CaioHVectorA/rover/README.md

# 🤖 Rover Móvel ESP32-S3 4WD & Pan/Tilt VR

Robô explorador terrestre com **tração integral 4WD**, cabeça articulada **Pan/Tilt** com streaming de vídeo de baixa latência e controle mobile imersivo via **Realidade Virtual (VR Head-Tracking)**.

---

### 🟢 Status do Projeto: **Robô montado & Testes práticos em andamento**
* **Hardware (V1 Montado):** Robô montado fisicamente (chassi 3D protótipo, rodas de 32 mm com 8 mm de vão livre, placa perfurada concluída).
* **Próxima Geração (PCB V2):** Transição direta para a PCB definitiva ([`rover_pcb_v2_chassi`](docs/hardware/kicad/rover_pcb_v2_chassi/MONTAGEM_3D.md)) com **ESP32 interno no chassi**, comunicação via **UART Serial Direta 3.3V** e áudio I2S (`INMP441` + `MAX98357A`).
* **Firmware & Visão:** ESP32-S3 e Nano operacionais com visão computacional (modo apresentador / gestos) em testes práticos.
* **Próximo passo:** Fabricar/montar a PCB V2, ajustar o chassi 3D para a nova placa e implementar o pipeline de vídeo UDP + servidor de IA.

---

## 🏗️ Arquitetura do Sistema

O projeto adota uma arquitetura **distribuída em 2 microcontroladores**, interligados por um chicote ultra-flexível de **apenas 3 a 4 fios**:

```mermaid
flowchart TD
    subgraph APP["📱 App Mobile (Expo / React Native) / Navegador Web"]
        VR["Modo VR Head-Tracking / FPV"]
        WS_CLI["WebSocket Client (JSON ou ASCII @ 35Hz)"]
        STREAM_CLI["Player de Vídeo MJPEG (:82/stream)"]
    end

    subgraph CABECA["📸 Cabeça Móvel (Pan / Tilt)"]
        ESP["ESP32-S3-CAM (Wi-Fi + Câmera 5MP OV5640)"]
        HTTPD["esp_http_server Dedicado no Core 0 (:82)"]
        CAM_PWR["Soneca Térmica no Reg. 0x3008"]
    end

    subgraph CHASSI["⚡ Chassi Fixo Inferior"]
        STEP["Mini 560 (5V / até 5A)"]
        BAT["Bateria Li-Ion 2S (7.4V 2500mAh)"]
        NANO["Arduino Nano V3 (5V Nativo)"]
        DRIVER["Driver TB6612FNG (MOSFET Duplo)"]
        MOTORES["4x Motores DC JGA16-050"]
        SERVOS["2x Micro Servos SG90 (Pan/Tilt)"]
        RAMPA["Rampa Soft-Start & Dead-Time"]
    end

    APP <== "Wi-Fi (Portas 80, 81 e 82)" ==> ESP
    BAT --> STEP
    BAT --> DRIVER

    %% Chicote Flexível
    STEP -.->|"Fio 1: 5.0V (Potência)"| ESP
    NANO -.->|"Fio 2: GND Comum"| ESP
    ESP -.->|"Fio 3: IO43 TX -> Nano D2 RX (via BC337 ou D0 direto)"| NANO
    NANO -.->|"Fio 4 (Opcional): Nano D1 TX -> Divisor 1k/2k -> IO44 RX"| ESP

    NANO --> DRIVER --> MOTORES
    NANO --> SERVOS
```

---

## 🔬 Suíte dos 6 POCs (Testes de Bancada Independentes)

Cada subsistema foi desacoplado para testes isolados e seguros:

| POC | Descrição | Placa & Ambiente | O que testa / resolve |
|---|---|---|---|
| **POC 1** | [Enlace Serial RX/TX](file:///c:/Users/caihe/Documents/develop/rover/docs/pocs/GUIA_EXECUCAO_POCS.md#poc-1-teste-de-enlace-serial-rxtx-com-servidor-web) | `poc1_esp32` + `poc1_nano` | Medição de ping/RTT, taxa de entrega de 100% e diagnóstico de reset do Nano |
| **POC 2** | [Pan/Tilt Controlado (Sem Vídeo)](file:///c:/Users/caihe/Documents/develop/rover/docs/pocs/GUIA_EXECUCAO_POCS.md#poc-2-pantilt-controlado-sem-v%C3%ADdeo) | `poc2_esp32` + `poc2_nano` | Eliminação do "rebolado" via interpolação em microssegundos (50 Hz) e varredura lenta |
| **POC 3** | [Transmissão de Vídeo Fria](file:///c:/Users/caihe/Documents/develop/rover/docs/pocs/GUIA_EXECUCAO_POCS.md#poc-3-transmiss%C3%A3o-de-v%C3%ADdeo-fria-esp32-isolado) | `poc3_esp32` | Soneca no reg. `0x3008`, XCLK adaptativo (8–12 MHz) e servidor no Core 0 (câmera fria) |
| **POC 4** | [Pan/Tilt + Transmissão](file:///c:/Users/caihe/Documents/develop/rover/docs/pocs/GUIA_EXECUCAO_POCS.md#poc-4-pantilt--transmiss%C3%A3o-desempenho-da-imagem) | `poc4_esp32` + `poc2_nano` | Operação simultânea com modo Eco automático (cai para 5 FPS parado) e zero bloqueio |
| **POC 5** | [Teste Automático dos Motores](file:///c:/Users/caihe/Documents/develop/rover/docs/pocs/GUIA_EXECUCAO_POCS.md#poc-5-teste-autom%C3%A1tico-de-motores-4wd-bancada-com-rodas-no-ar) | `poc5_nano` (baud 115200) | Sequência autônoma de vai-e-volta, giros e rampa com medição de queda (*sag*) de bateria |
| **POC 6** | [Motores Controlados](file:///c:/Users/caihe/Documents/develop/rover/docs/pocs/GUIA_EXECUCAO_POCS.md#poc-6-motores-controlados-joystick-virtual--teclado) | `poc6_esp32` + `poc6_nano` | Pilotagem manual (joystick touch / teclado WASD), watchdog de 600ms e rampa anti-reset |

📖 **Consulte o [Guia Completo de Execução dos POCs](file:///c:/Users/caihe/Documents/develop/rover/docs/pocs/GUIA_EXECUCAO_POCS.md)** para instruções de compilação, gravação e checklist.

---

## 📂 Organização Limpa da Codebase

```
rover/
├── README.md                      # Visão geral, arquitetura e quickstart
├── AGENTS.md                      # Diretrizes obrigatórias e regras para agentes de IA
├── style.md                       # Perfil de engenharia, tom de bancada e preferências
├── platformio.ini                 # Configuração unificada de build de todos os ambientes
│
├── docs/                          # Documentação técnica central
│   ├── context.md                 # 📖 Memória técnica contínua e histórico completo do projeto
│   ├── pocs/                      # Documentação da suíte de 6 POCs incrementais
│   │   ├── README.md              # Índice dos POCs e tabela de ambientes
│   │   └── GUIA_EXECUCAO_POCS.md  # Manual prático de gravação e teste passo a passo
│   ├── hardware/                  # Especificações técnicas, desenhos com cotas e pinagens
│   │   ├── ESPECIFICACOES_TECNICAS.md
│   │   ├── tabela_pinagem_esp32_nano.xlsx
│   │   ├── PROJETO_CONEXOES_PLACA_PERFURADA.docx
│   │   ├── kicad/                 # Projetos de circuitos e esquemáticos KiCad
│   │   └── *.png                  # Desenhos técnicos oficiais (JGA-050, SG90, StickyMAX)
│   ├── guides/                    # Guias de engenharia aprofundados
│   │   ├── camera_calor_software.md          # ❄️ Otimização térmica do OV5640 via software
│   │   ├── ajuste_fino_servos_rebolado.md    # 🎯 Física e eliminação do rebolado nos servos SG90
│   │   ├── tracao_motores_anti_reset.md      # ⚡ Prevenção de Brown-Out e rampa 4WD na TB6612
│   │   ├── controle_servos_head_tracking_vr.md # Guia didático de servos e VR Head-Tracking
│   │   ├── http_vs_websocket_redes.md        # Análise comparativa de protocolos de rede
│   │   └── streaming_video_baixa_latencia.md # Pipeline de vídeo MJPEG e baixa latência
│   ├── compras/                   # Histórico de compras, orçamentos e fotos das lojas
│   └── references/                # Fotos reais dos produtos e montagens maker de referência
│
├── src/                           # Código-fonte do projeto
│   ├── firmware/                  # Códigos C++ / Arduino organizados por módulo
│   │   ├── comum/                 # Módulos compartilhados reutilizáveis (câmera, enlace, rampa, servos)
│   │   ├── pocs/                  # Códigos-fonte dos 6 POCs isolados
│   │   ├── gateway_app/           # Firmware de produção integrado ao App Mobile Expo
│   │   └── legado/                # Sketches e testes históricos arquivados
│   ├── app_mobile/                # Aplicativo Expo / React Native (VR, FPV e Dashboard)
│   └── servidor_relay/            # Servidor Node.js / Docker para teleoperação em nuvem
│
└── tools/                         # Ferramentas auxiliares e geradores Python
    └── scratch/                   # Scripts utilitários de apoio
```

---

## ⚡ Comandos de Compilação e Gravação (PlatformIO)

Substitua `COMx` pelas portas seriais reais conectadas:

```powershell
# Gravação do ESP32-S3 (Exemplo POC 4: Pan/Tilt + Câmera):
pio run -e poc4_esp32 -t upload --upload-port COM24

# Gravação do Arduino Nano (Exemplo POC 2/4: Servos Suaves):
pio run -e poc2_nano -t upload --upload-port COM18

# Teste autônomo dos motores (POC 5):
pio run -e poc5_nano -t upload --upload-port COM18
pio device monitor -e poc5_nano --port COM18
```

---

## ⚙️ Componentes Físicos Adquiridos & Validados

| Componente | Modelo / Especificação | Função no Rover |
| :--- | :--- | :--- |
| **Motores de Tração** | 4x **JGA16-050** (16mm, redução metálica, eixo D 3mm) | Tração 4WD com torque elevado |
| **Rodas** | 4x **Rodas 32 mm** com cubo de fixação | Diâmetro externo de 32 mm elevando o vão livre para 8,0 mm |
| **Placa de Visão** | **ESP32-S3-CAM N16R8** (16MB Flash, 8MB PSRAM, OV5640 5MP) | Câmera, Wi-Fi e Streaming UDP Zero-Buffer |
| **Placa de Potência** | **Arduino Nano V3** (ATmega328P, 5V nativo) -> Migrando para **ESP32 DevKit V2** | Comanda TB6612, servos, buzzer e lê bateria |
| **Driver de Motores** | **TB6612FNG** (Ponte H MOSFET dupla, 1.2A/canal contínuo) | Controle de velocidade PWM e sentido 4WD |
| **Mecanismo Pan/Tilt** | 2x Micro Servos **SG90 9g** (Torque 1.6 kgf·cm) | Orientação horizontal e vertical da câmera |
| **Regulador de Tensão** | Step-Down **Mini 560** (5V fixos / até 5A) | Linha de 5V estável para placas e servos |
| **Bateria** | Li-Ion **2S 7.4V 2500mAh** com placa BMS integrada | Alimentação geral do robô |

> 📌 **Vão Livre ao Solo (Ground Clearance Real):**
> $$\text{Raio da Roda (16 mm)} - \text{Raio do Motor JGA (8 mm)} = \mathbf{8{,}0\text{ mm}}$$
> *A elevação para rodas de 32 mm resolveu o vão livre crítico de 3 mm das rodas de 22 mm anteriores, permitindo rodar em pisos reais sem raspar o motor.*
