CaioHVectorA/rover/ROADMAP.md

# 🗺️ Roadmap de Desenvolvimento - Robô Móvel ESP32-S3

Este documento estabelece o **plano de execução e marcos (milestones)** para o desenvolvimento do robô móvel. O foco primordial é a entrega rápida de um **MVP (Produto Mínimo Viável)** 100% funcional em rede Wi-Fi local antes de avançar para funcionalidades secundárias ou conexão de longa distância.

> 📚 **Documentos Relacionados:**
> * 🧠 [**`MEMORIA_DO_PROJETO.md`**](file:///home/usuario/Documentos/rover/MEMORIA_DO_PROJETO.md): Histórico completo de conversas, justificativas técnicas e soluções de engenharia.
> * 🛒 [**`linha-esp32-s3/LISTA_DE_COMPRAS.md`**](file:///home/usuario/Documentos/rover/linha-esp32-s3/LISTA_DE_COMPRAS.md): Lista consolidada de componentes no Mercado Livre e RoboCore.
> * 🏠 [**`README.md`**](file:///home/usuario/Documentos/rover/README.md): Visão geral do repositório.

---

## 🎯 1. Canvas do MVP (Visão Visual Rápida)

```
+---------------------------------------------------------------------------------------------------------+
|                                        CANVAS DO PROJETO - MVP                                          |
+------------------------------------+------------------------------------+-------------------------------+
| 1. OBJETIVO DO MVP                 | 2. HARDWARE DO MVP                 | 3. PILHA DE SOFTWARE          |
| • Robô 4WD comandado remotamente   | • ESP32-S3 CAM (N16R8 + OV5640)    | • Framework: Arduino/ESP-IDF  |
| • Streaming contínuo de vídeo      | • 4x Micromotores + 4 Rodas        | • Web Server: AsyncWebServer  |
| • Câmera com Pan & Tilt 2 eixos    | • Ponte H (L9110/MX1616 ou L298N)  | • Vídeo: Driver esp_camera    |
| • Operação em Wi-Fi Local (<100ms) | • 2x Micro Servos 9g SG90          | • Interface: HTML5/JS Web App |
|                                    | • Bateria 2S 18650 + Step-Down 5V  | • Comunicação: WebSockets     |
+------------------------------------+------------------------------------+-------------------------------+
| 4. INTERFACE DE CONTROLE (WEB APP) | 5. CRITÉRIO DE SUCESSO DO MVP      | 6. FASE SEGUINTE (PÓS-MVP)    |
| • Joystick/botões na tela          | • Pilotagem fluida pelo celular    | • Iluminação RGB (WS2812B)    |
| • Janela de vídeo ao vivo (MJPEG)  | • Câmera apontando em tempo real   | • Feedback sonoro (Buzzer)    |
| • Sliders para Pan e Tilt          | • Zero travamentos ou brownouts    | • Teleoperação 4G / Longa     |
| • Telemetria de sinal Wi-Fi        | • Sem quebra do flat da câmera     |   distância via internet      |
+------------------------------------+------------------------------------+-------------------------------+
```

---

## 📊 2. Diagrama de Fluxo de Fases

```mermaid
flowchart TD
    subgraph FASE_1 ["Fase 1: Bancada & Testes Unitários"]
        A1[Testar ESP32-S3 CAM com CameraWebServer] --> A2[Testar Servos Pan/Tilt em Bancada]
        A2 --> A3[Testar Ponte H e 4 Micromotores]
        A3 --> A4[Calibrar Step-Down para 5.0V]
    end

    subgraph FASE_2 ["Fase 2: Montagem Mecânica & Elétrica"]
        B1[Fixar Micromotores e Rodas no Chassi] --> B2[Instalar Suporte Pan/Tilt com o ESP32]
        B2 --> B3[Passar Chicote Flexível com Folga]
        B3 --> B4[Montar Bateria, Chave e Step-Down]
    end

    subgraph FASE_3 ["Fase 3: Firmware & Interface do MVP"]
        C1[Servidor Web com Streaming de Vídeo] --> C2[Endpoint WebSocket para Comandos Baixa Latência]
        C2 --> C3[Interface Web Mobile Responsiva]
        C3 --> C4[Validação Prática de Condução Wi-Fi]
    end

    subgraph FASE_4 ["Fase 4: Recursos Sensoriais"]
        D1[Instalação do Buzzer e Sons de Alerta] --> D2[Instalação dos LEDs RGB WS2812B]
    end

    subgraph FASE_5 ["Fase 5: Longa Distância & Internet"]
        E1[Túnel Reverso Seguro tipo Cloudflare/Tailscale] --> E2[Módulo Modem 4G LTE ou Roteador Móvel]
        E2 --> E3[Telepresença e Pilotagem Global]
    end

    FASE_1 --> FASE_2
    FASE_2 --> FASE_3
    FASE_3 --> FASE_4
    FASE_4 --> FASE_5

    style FASE_3 fill:#e1f5fe,stroke:#0288d1,stroke-width:2px
    style C4 fill:#c8e6c9,stroke:#388e3c,stroke-width:2px
```

---

## 📅 3. Cronograma Detalhado por Etapas

### 📍 Fase 1: Bancada & Validação Isolada (Zero Risco)
*Objetivo: Testar cada módulo separadamente na mesa antes de parafusar no chassi.*
* [x] **1.1 Câmera no ESP32-S3 & Conexão Wi-Fi:** Validar rádio Wi-Fi, estabilidade de alimentação (eliminação de resets de Brownout) e streaming de vídeo no ESP32-S3 CAM.
* [ ] **1.2 Controle de Servos:** Criar um sketch simples em C++ variando o ângulo de 0° a 180° nos GPIOs dos servos para calibrar o ponto central (90°).
* [ ] **1.3 Rotação dos Motores:** Ligar a ponte H na bancada e acionar os motores para frente, ré e viragem para verificar a polaridade correta dos fios.
* [ ] **1.4 Tensão Segura:** Ajustar o trimpot do regulador Step-Down com multímetro exatamente em **5.00V** antes de conectar qualquer componente eletrônico.

---

### 📍 Fase 2: Montagem Físico-Mecânica
*Objetivo: Integrar os componentes de forma firme, limpa e com proteção mecânica.*
* [ ] **2.1 Montagem da Tração:** Parafusar os 4 suportes em "L", acoplar os micromotores e prender as rodas emborrachadas.
* [ ] **2.2 Montagem do Pan/Tilt:** Montar a estrutura de 2 eixos com os servos SG90 e fixar o ESP32-S3 na base superior móvel.
* [ ] **2.3 Chicote Elétrico com Alívio de Tensão:** Descer os fios de alimentação e sinal em formato de alça (arco flexível) para que o movimento de rotação (Pan) e inclinação (Tilt) não estique nenhum conector.
* [ ] **2.4 Distribuição de Massa:** Posicionar as baterias 18650 na parte central/baixa do chassi para garantir centro de gravidade baixo e estabilidade nas curvas.

---

### 📍 Fase 3: Firmware & Interface Unificada (Marco do MVP 🚀)
*Objetivo: Entregar o robô 100% funcional e pilotável via Wi-Fi.*
* [ ] **3.1 Arquitetura de Software Pronta no ESP32:**
  * O ESP32-S3 já possui suporte nativo por hardware para captura de vídeo em MJPEG via PSRAM.
  * O firmware unificado combina:
    1. **Streamer de Vídeo:** Rota HTTP contínua (`/stream`).
    2. **Servidor de Páginas:** Hospeda uma página web única e leve em HTML5/CSS/JavaScript.
    3. **Comunicação em Tempo Real:** Via **WebSocket** (`/ws`) para receber comandos de direção e posição dos servos com latência quase nula (<50ms).
* [ ] **3.2 Controles na Interface Web:**
  * Teclas virtuais ou Joystick analógico (W, A, S, D ou botões na tela sensível ao toque);
  * Sliders ou controle tátil para Pan (esquerda/direita) e Tilt (cima/baixo);
  * Exibição da taxa de quadros (FPS) e nível de sinal Wi-Fi (RSSI).
* [ ] **3.3 Validação de Campo:** Pilotar o robô dentro de casa/sala de aula via Wi-Fi local.

---

### 📍 Fase 4: Recursos Sensoriais & Feedback (Refinamento)
*Objetivo: Adicionar personalidade e sinalização ao robô.*
* [ ] **4.1 Feedback Sonoro (Buzzer):**
  * Beep duplo ao ligar e conectar no Wi-Fi;
  * Beep de marcha à ré ou buzina acionável pela interface web.
* [ ] **4.2 Iluminação Visual (LEDs WS2812B):**
  * Faróis dianteiros (luz branca para iluminar a câmera no escuro);
  * Lanternas traseiras (vermelho aceso ao frear ou dar ré);
  * Efeito pulsante indicando busca de conexão Wi-Fi.

---

### 📍 Fase 5: Conexão de Longa Distância & Sistemas Distribuídos na Nuvem (Fly.io 🚀)
*Objetivo: Controlar o robô de qualquer lugar do planeta pela internet com medição de latência.*
* [ ] **5.1 Servidor Relay na Nuvem (Fly.io `gru`):**
  * Deploy de servidor Node.js/WebSocket na região de São Paulo (`gru`) para receber o fluxo de vídeo e telemetria do robô via porta 443 HTTPS/WSS (ultrapassando qualquer firewall/CGNAT).
* [ ] **5.2 Firmware Cliente do ESP32-S3 (Push Binário):**
  * O ESP32-S3 atua como cliente ativo enviando pacotes binários brutos (Frame ID + Timestamp millis + Bytes JPEG) via WebSocket Seguro (`wss://`).
* [ ] **5.3 Medição de Latência Fim-a-Fim (Two-Leg RTT):**
  * Exibição no HUD do painel de controle da latência exata da rede do robô, da rede do piloto e do FPS real entregue.
