CaioHVectorA/rover/docs/hardware/kicad/rover_perfurada_90x150/ligacoes_furo_a_furo.csv

Rede | Origem | Coluna | Linha | Destino | Coluna | Linha
VBAT | BAT+ | 22 | 3 | MINI:IN+ | 22 | 10
GND | BAT- | 27 | 3 | MINI:IN- | 22 | 14
VBAT | MINI:IN+ | 22 | 10 | TB:VM | 18 | 10
+5V | MINI:OUT+ | 33 | 10 | N:5V | 15 | 37
+5V | MINI:OUT+ | 33 | 10 | TB:VCC | 18 | 11
+5V | MINI:OUT+ | 33 | 10 | ESP:5V | 32 | 40
+5V | MINI:OUT+ | 33 | 10 | PAN:5V | 6 | 54
+5V | MINI:OUT+ | 33 | 10 | TILT:5V | 15 | 54
+5V | MINI:OUT+ | 33 | 10 | R2:1 | 21 | 35
GND | MINI:OUT- | 33 | 14 | N:GND-R | 15 | 35
GND | MINI:OUT- | 33 | 14 | TB:GND | 18 | 12
GND | MINI:OUT- | 33 | 14 | ESP:GND | 32 | 42
GND | MINI:OUT- | 33 | 14 | PAN:GND | 8 | 54
GND | MINI:OUT- | 33 | 14 | TILT:GND | 17 | 54
GND | MINI:OUT- | 33 | 14 | Q:E | 25 | 39
STBY | N:D12 | 9 | 48 | TB:STBY | 6 | 10
PWMA | N:D3 | 9 | 39 | TB:PWMA | 6 | 11
AIN1 | N:D4 | 9 | 40 | TB:AIN1 | 6 | 12
AIN2 | N:D5 | 9 | 41 | TB:AIN2 | 6 | 13
PWMB | N:D6 | 9 | 42 | TB:PWMB | 6 | 14
BIN1 | N:D7 | 9 | 43 | TB:BIN1 | 6 | 15
BIN2 | N:D8 | 9 | 44 | TB:BIN2 | 6 | 16
AO1 | TB:AO1 | 18 | 13 | E1:1 | 3 | 4
AO1 | TB:AO1 | 18 | 13 | E2:1 | 8 | 4
AO2 | TB:AO2 | 18 | 14 | E1:2 | 5 | 4
AO2 | TB:AO2 | 18 | 14 | E2:2 | 10 | 4
BO1 | TB:BO1 | 18 | 15 | D1:1 | 13 | 4
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
