CaioHVectorA/rover/docs/hardware/desenho_tecnico_micro_servo_sg90.png

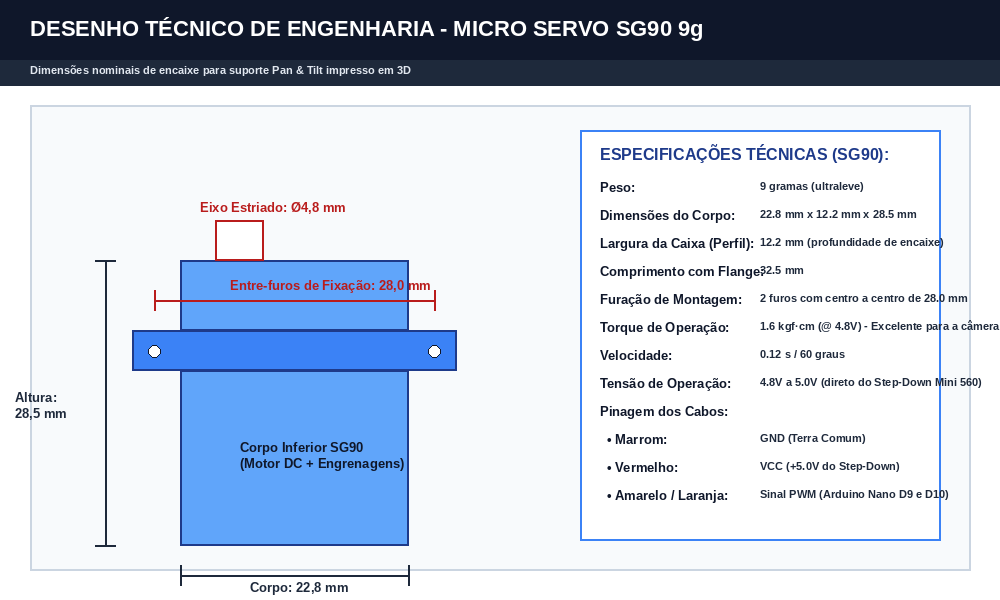
docs/hardware/desenho_tecnico_micro_servo_sg90.png
