CaioHVectorA/rover/docs/hardware/encaixe_servo_horn_rebaixo_cad.png

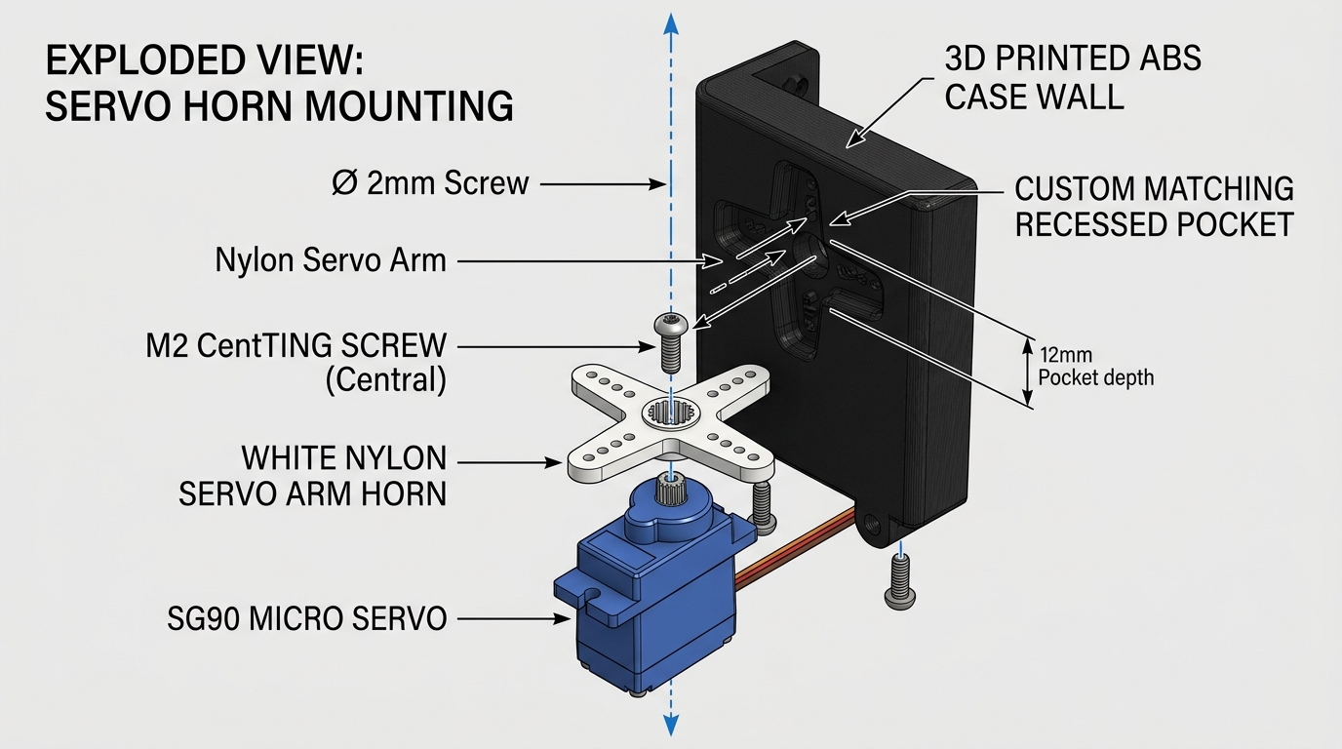
docs/hardware/encaixe_servo_horn_rebaixo_cad.png
