CaioHVectorA/rover/docs/hardware/kicad/rover_pcb_v2_chassi/preview_3d.png

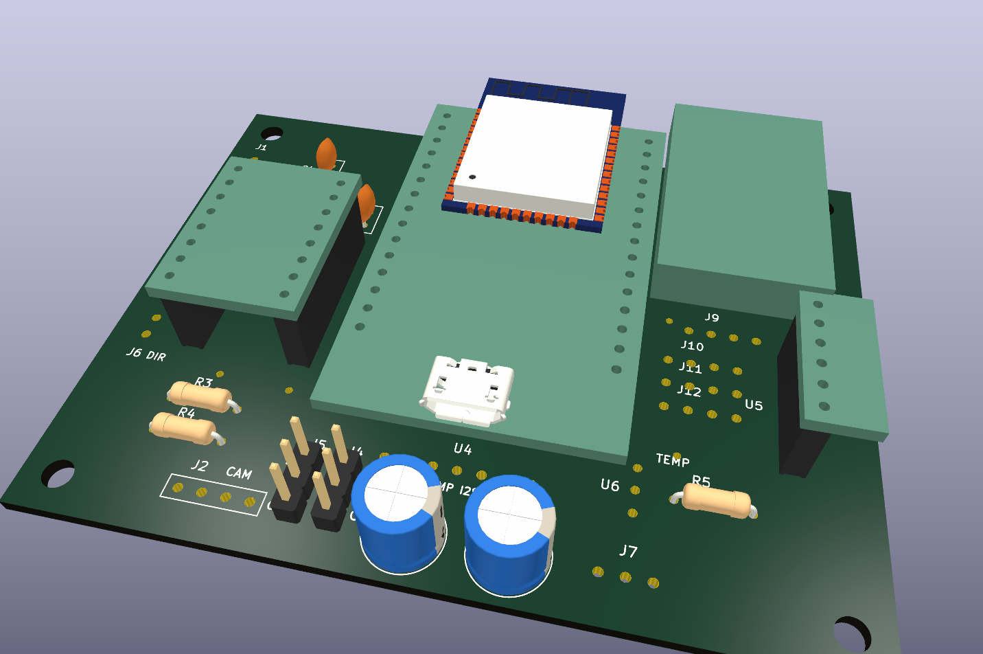
docs/hardware/kicad/rover_pcb_v2_chassi/preview_3d.png
