CaioHVectorA/rover/docs/hardware/kicad/rover_pcb_v2_chassi/preview_pcb_top.png

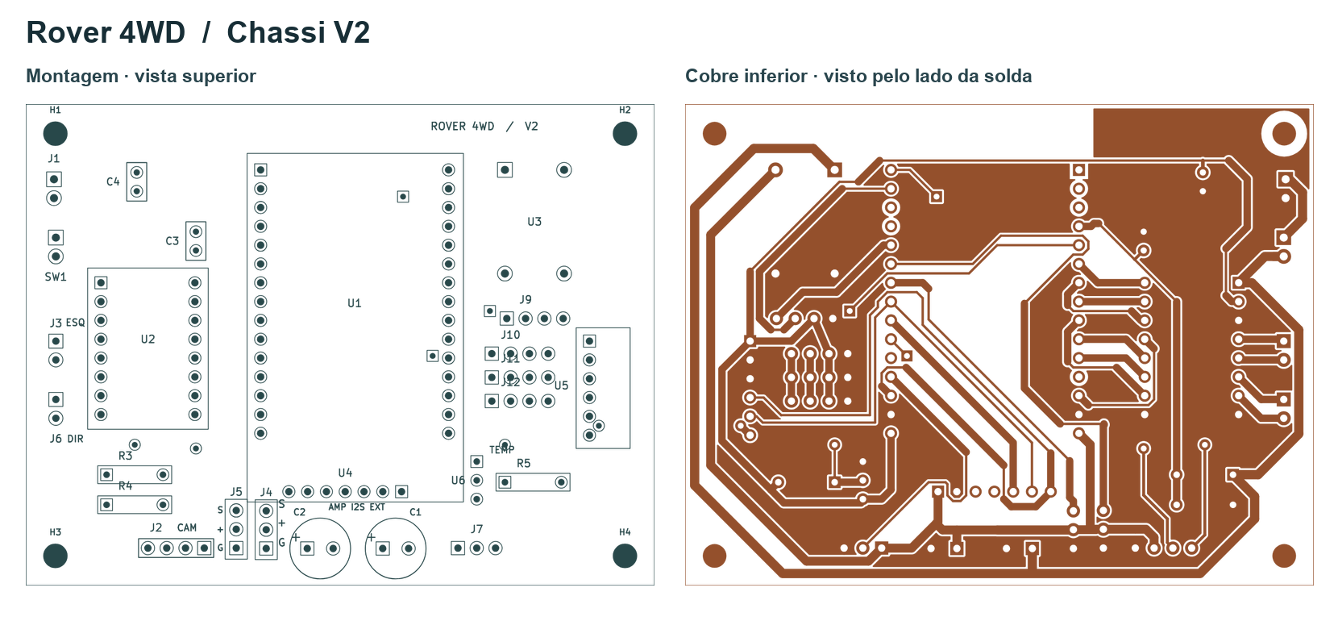
docs/hardware/kicad/rover_pcb_v2_chassi/preview_pcb_top.png
