CaioHVectorA/rover/docs/hardware/kicad/rover_perfurada_90x150/distribuicao_superior.png

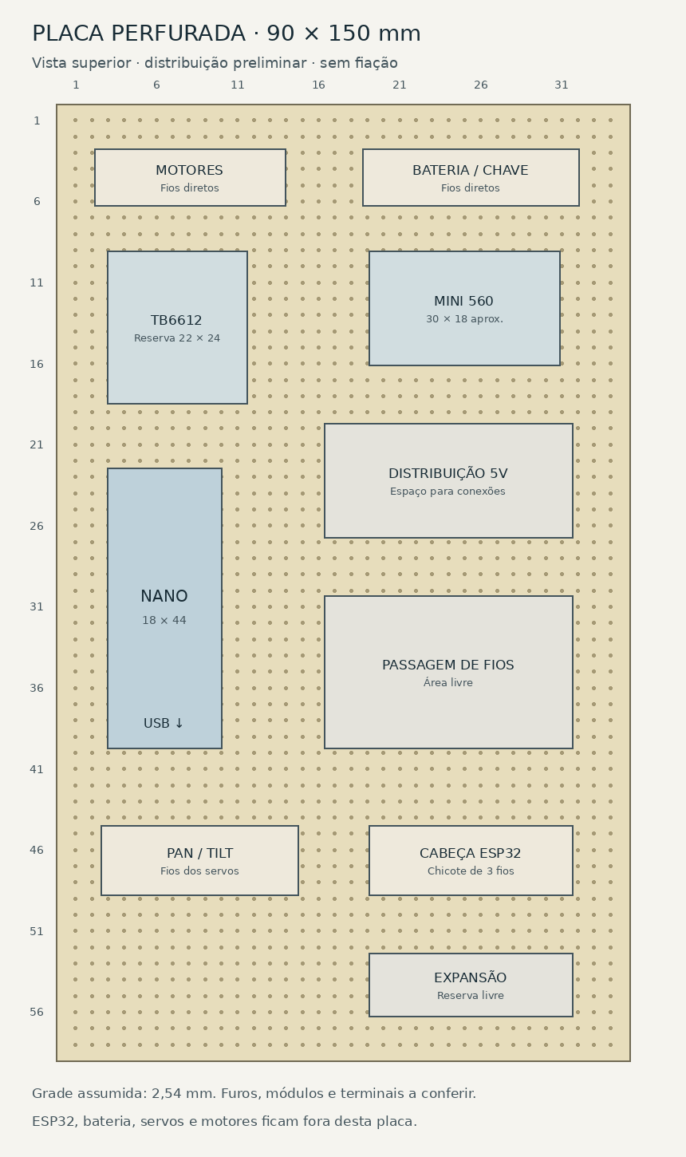
docs/hardware/kicad/rover_perfurada_90x150/distribuicao_superior.png
