CaioHVectorA/rover/docs/hardware/kicad/rover_serial_bridge/preview_perfboard_3d.png

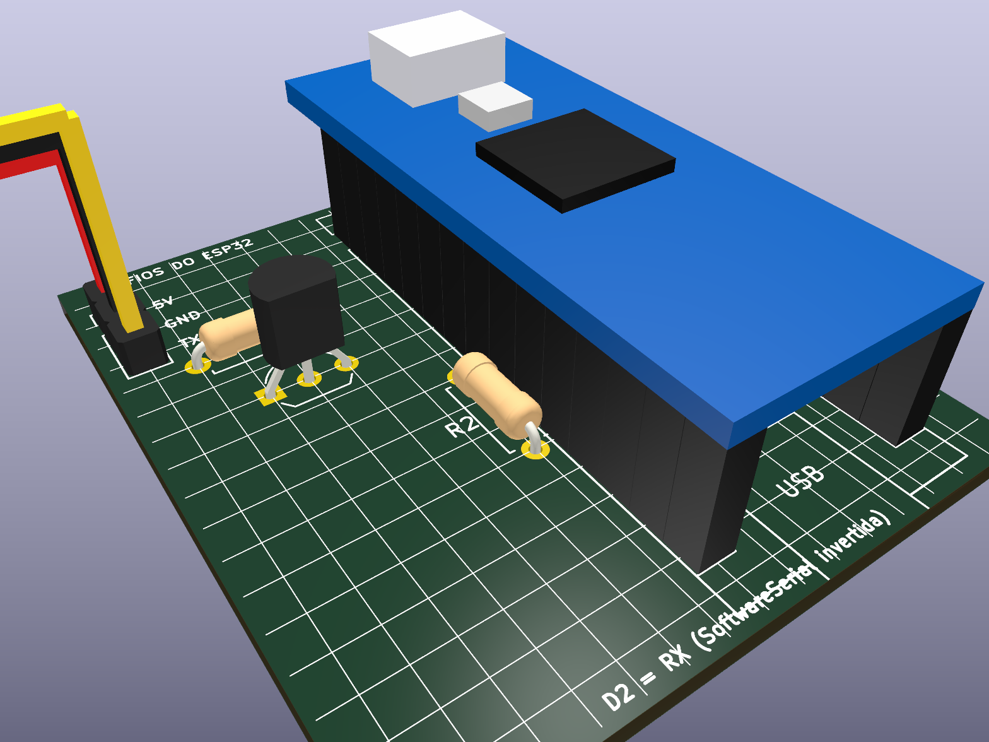
docs/hardware/kicad/rover_serial_bridge/preview_perfboard_3d.png
