CaioHVectorA/rover/docs/hardware/kicad/rover_serial_bridge/preview_perfboard_top.png

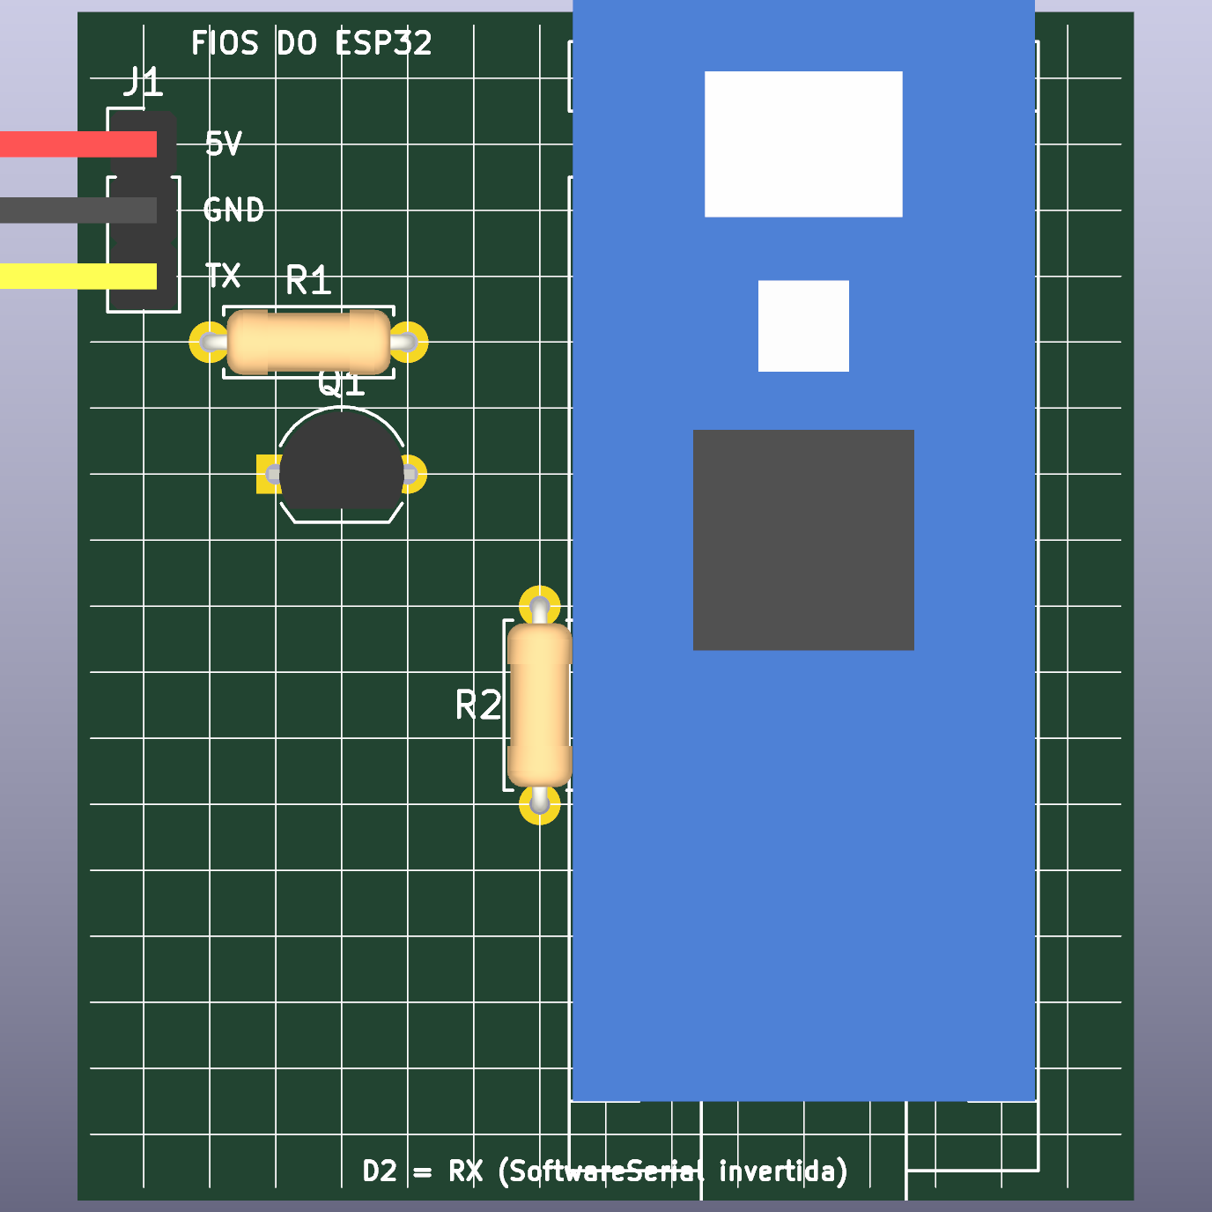
docs/hardware/kicad/rover_serial_bridge/preview_perfboard_top.png
