CaioHVectorA/rover/docs/references/motor_jga16_050_robocore.png

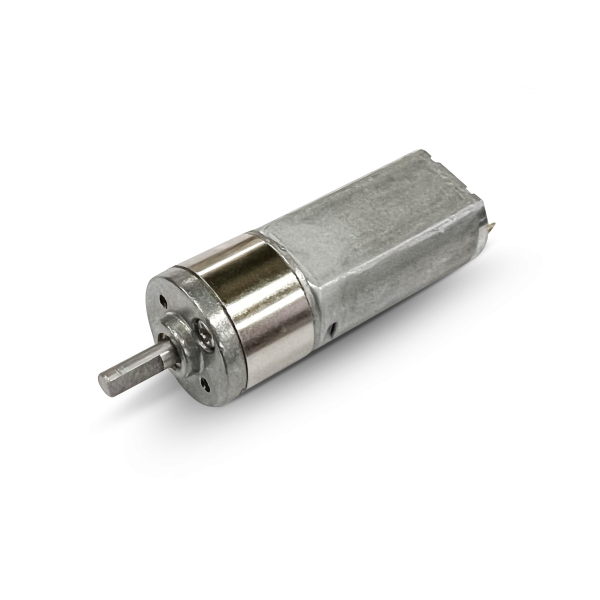
docs/references/motor_jga16_050_robocore.png
