CaioHVectorA/rover/docs/references/pan_tilt_sg90_mechanism.jpg

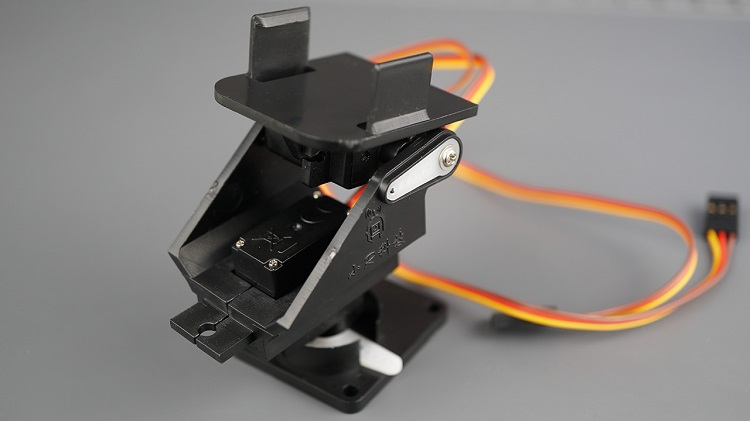
docs/references/pan_tilt_sg90_mechanism.jpg
