CaioHVectorA/rover/LISTA_DE_COMPRAS_PI.md

# 🛒 Lista de Compras - Robô Móvel Raspberry Pi 3 + Nano + VR

Lista consolidada de componentes para o robô com **Raspberry Pi 3** (Cérebro Linux & Streaming WebRTC), **Arduino Nano V3** (Controle em tempo real de 4 motores e 2 servos Pan/Tilt), **Giroscópio MPU-6050** (VR Head Tracking), iluminação e saída sonora.

> 📚 **Planilha Excel Gerada:**
> * 📄 [**`LISTA_DE_COMPRAS_ROVER.xlsx`**](file:///c:/Users/caihe/Documents/develop/rover/LISTA_DE_COMPRAS_ROVER.xlsx) (Aba: **Rover Raspberry Pi 3** - editável e com fórmulas automáticas).

---

## 1. Pedido Principal: RoboCore (`robocore.net`)
*O carrinho com todos os 25 itens já está carregado e pronto no navegador.*

| Item | Produto | Qtd | Preço Unit. | Subtotal | Link Direto na Loja |
|:---:|---|:---:|:---:|:---:|---|
| 1 | Micro Servo 9g SG90 (TowerPro) | 2 | R$ 13,67 | R$ 27,34 | [Abrir na RoboCore](https://www.robocore.net/atuador/micro-servo-9g-sg90-towerpro) |
| 2 | Câmera para Raspberry Pi Rev 1.3 (5MP) | 1 | R$ 49,90 | R$ 49,90 | [Abrir na RoboCore](https://www.robocore.net/acessorios-raspberry-pi/camera-para-raspberry-pi-rev-1-3) |
| 3 | Suporte Pan/Tilt para Câmera Raspberry Pi | 1 | R$ 6,90 | R$ 6,90 | [Abrir na RoboCore](https://www.robocore.net/item-mecanico/suporte-pan-tilt-para-camera-raspberry-pi) |
| 4 | Micro Motor com Redução Metálica 6V 100RPM (Eixo D 3mm) | 4 | R$ 29,90 | R$ 119,60 | [Abrir na RoboCore](https://www.robocore.net/motor-caixas-de-reducao/micro-motor-com-caixa-de-reducao-6v-100rpm) |
| 5 | StickyMAX - Roda S20 Macia (Silicone vulcanizado c/ cubo 3mm) | 4 | R$ 39,90 | R$ 159,60 | [Abrir na RoboCore](https://www.robocore.net/roda/roda-stickymax-s20-22mm) |
| 6 | Suporte para Micro Motores (Par Branco) | 2 pares (4 un) | R$ 9,90 | R$ 19,80 | [Abrir na RoboCore](https://www.robocore.net/item-mecanico/suporte-para-micro-motores) |
| 7 | Módulo Driver Ponte H - L298N (Driver 1: Esquerda) | 1 | R$ 14,90 | R$ 14,90 | [Abrir na RoboCore](https://www.robocore.net/driver-motor/driver-motor-ponte-h-l298n) |
| 8 | Módulo Driver Ponte H - L298N (Driver 2: Direita) | 1 | R$ 14,90 | R$ 14,90 | [Abrir na RoboCore](https://www.robocore.net/driver-motor/driver-motor-ponte-h-l298n) |
| 9 | Conversor DC/DC Step Down Mini 560 5V (até 5A síncrono) | 1 | R$ 7,50 | R$ 7,50 | [Abrir na RoboCore](https://www.robocore.net/regulador-de-tensao/conversor-dc-dc-step-down-mini-560-5v) |
| 10 | Pack Bateria Li-Ion 7,4V 2500mAh c/ BMS Integrado | 1 | R$ 69,90 | R$ 69,90 | [Abrir na RoboCore](https://www.robocore.net/baterias-fontes/pack-bateria-li-ion-7_4v-2500mah-com-bms) |
| 11 | Cabo JST-RCY 2 pinos Fêmea (Rabicho p/ Bateria) | 1 | R$ 1,90 | R$ 1,90 | [Abrir na RoboCore](https://www.robocore.net/cabo/cabo-jst-rcy-2-pinos-femea) |
| 12 | Módulo Buzzer 5V Passivo (Suporta PWM/Tons) | 1 | R$ 4,90 | R$ 4,90 | [Abrir na RoboCore](https://www.robocore.net/atuador/modulo-buzzer-5v-passivo) |
| 13 | Módulo WS2812 LED RGB Endereçável (Barra 8 LEDs) | 1 | R$ 9,90 | R$ 9,90 | [Abrir na RoboCore](https://www.robocore.net/led/modulo-ws2812-led-enderecavel-8-leds) |
| 14 | Chave Gangorra KCD1-101 2T (Liga/Desliga) | 1 | R$ 1,50 | R$ 1,50 | [Abrir na RoboCore](https://www.robocore.net/botao-chave/chave-gangorra-kcd1-101-2t) |
| 15 | Jumpers Fêmea-Fêmea x40 Unidades | 1 | R$ 6,90 | R$ 6,90 | [Abrir na RoboCore](https://www.robocore.net/cabo/jumpers-femea-femea-x40-unidades) |
| 16 | Jumpers Macho-Macho x40 Cabos | 1 | R$ 7,90 | R$ 7,90 | [Abrir na RoboCore](https://www.robocore.net/cabo/jumpers-macho-macho-x40-cabos) |
| 17 | Placa Arduino Nano V3 + Cabo USB | 1 | R$ 28,90 | R$ 28,90 | [Abrir na RoboCore](https://www.robocore.net/placa-arduino/placa-nano-v3-com-cabo-usb-para-arduino) |

### 💰 Totais RoboCore (25 itens no carrinho):
* **Subtotal dos Produtos:** R$ 552,24
* **Total com Desconto no PIX (5% off):** **`R$ 524,63`**
* **Total no Cartão de Crédito:** **`R$ 552,24`** (em até **3x de R$ 184,08 sem juros**)

---

## 2. Mercado Livre (Raspberry Pi 3, Cartão MicroSD A1 & Giroscópio - Links Diretos de Produto)

| Item | Componente | Produto | Qtd | Preço de Mercado | Link Direto do Produto |
|:---:|---|---|:---:|:---:|---|
| 18 | **Cérebro Principal** | Placa Raspberry Pi 3 Model B *(caso não possua)* | 1 | R$ 389,00 | [Abrir Produto no ML](https://www.mercadolivre.com.br/raspberry-pi3-pi-3-model-b-quadcore-12ghz/p/MLB42963336) |
| 19 | **Armazenamento (Ideal)** | Cartão MicroSD **64GB** SanDisk Ultra A1 Classe 10 (120 MB/s) | 1 | R$ 69,90 | [Abrir Produto no ML (64GB)](https://www.mercadolivre.com.br/memoria-microsd-profissional-sandisk-ultra-64gb-120-mbs-a1/p/MLB23033439) |
| *alt* | *Armazenamento (Mínimo)* | *Cartão MicroSD 32GB SanDisk Ultra A1 Classe 10* | *1* | *R$ 49,90* | *[Abrir Opção 32GB no ML](https://www.mercadolivre.com.br/cartao-de-memoria-micro-sd-sandisk-ultra-32gb-120mbs-c10-a1/p/MLB20654826)* |
| 20 | **Giroscópio / VR (Head Tracking)** | Módulo GY-521 MPU-6050 (Acelerômetro + Giroscópio 6DOF) | 1 | R$ 19,90 | [Abrir Produto no ML](https://www.mercadolivre.com.br/modulo-acelerometro-giroscopio-mpu6050-gy521/up/MLBU4448831937) |

* **Subtotal Estimado Mercado Livre (com Pi 3 nova + SD 64GB):** R$ 478,80
* **Subtotal Mercado Livre (Se você já tiver a Raspberry Pi 3):** R$ 89,80 (SD 64GB + MPU-6050)

---

## 💵 Custo Total Geral Estimado

* **Com Raspberry Pi 3 nova (RoboCore no PIX + Mercado Livre c/ SD 64GB):** **`R$ 1.003,43`**
* **Se você já possuir a Raspberry Pi 3 (RoboCore no PIX + MicroSD 64GB + MPU-6050):** **`R$ 614,43`**
