CaioHVectorA/rover/LISTA_DE_COMPRAS_ROVER.xlsx

Sheet: Rover ESP32-S3
Item | Produto | Loja | Qtd | Preço Unitário (R$) | Preço à Vista PIX (R$) | Subtotal à Vista (R$) | Opcional (0/1) | Link Direto
1 | Micro Servo 9g SG90 (TowerPro) | RoboCore | 2 | R$13.67 |  |  | 0 | Abrir Produto (https://www.robocore.net/atuador/micro-servo-9g-sg90-towerpro)
2 | Micro Motor DC 6V 100RPM Redução Metal | RoboCore | 4 | R$29.90 |  |  | 0 | Abrir Produto (https://www.robocore.net/motor-caixas-de-reducao/micro-motor-com-caixa-de-reducao-6v-100rpm)
3 | StickyMAX - Roda S20 Macia 22mm | RoboCore | 4 | R$39.90 |  |  | 0 | Abrir Produto (https://www.robocore.net/roda/roda-stickymax-s20-22mm)
4 | Suporte para Micro Motores (Par Branco) | RoboCore | 2 | R$9.90 |  |  | 0 | Abrir Produto (https://www.robocore.net/item-mecanico/suporte-para-micro-motores)
5 | Módulo Driver Ponte H - L298N (Driver 1) | RoboCore | 1 | R$14.90 |  |  | 0 | Abrir Produto (https://www.robocore.net/driver-motor/driver-motor-ponte-h-l298n)
6 | Módulo Driver Ponte H - L298N (Driver 2) | RoboCore | 1 | R$14.90 |  |  | 0 | Abrir Produto (https://www.robocore.net/driver-motor/driver-motor-ponte-h-l298n)
7 | Conversor DC/DC Step Down Mini 560 5V (5A) | RoboCore | 1 | R$7.50 |  |  | 0 | Abrir Produto (https://www.robocore.net/regulador-de-tensao/conversor-dc-dc-step-down-mini-560-5v)
8 | Pack Bateria Li-Ion 7,4V 2500mAh com BMS | RoboCore | 1 | R$69.90 |  |  | 0 | Abrir Produto (https://www.robocore.net/baterias-fontes/pack-bateria-li-ion-7_4v-2500mah-com-bms)
9 | Cabo JST-RCY 2 pinos Fêmea | RoboCore | 1 | R$1.90 |  |  | 0 | Abrir Produto (https://www.robocore.net/cabo/cabo-jst-rcy-2-pinos-femea)
10 | Módulo Buzzer 5V Passivo | RoboCore | 1 | R$4.90 |  |  | 1 | Abrir Produto (https://www.robocore.net/atuador/modulo-buzzer-5v-passivo)
11 | Módulo WS2812 LED RGB (Barra 8 LEDs) | RoboCore | 1 | R$9.90 |  |  | 1 | Abrir Produto (https://www.robocore.net/led/modulo-ws2812-led-enderecavel-8-leds)
12 | Chave Gangorra KCD1-101 2T | RoboCore | 1 | R$1.50 |  |  | 0 | Abrir Produto (https://www.robocore.net/botao-chave/chave-gangorra-kcd1-101-2t)
13 | Jumpers Fêmea-Fêmea x40 Unidades | RoboCore | 1 | R$6.90 |  |  | 0 | Abrir Produto (https://www.robocore.net/cabo/jumpers-femea-femea-x40-unidades)
14 | Jumpers Macho-Macho x40 Cabos | RoboCore | 1 | R$7.90 |  |  | 0 | Abrir Produto (https://www.robocore.net/cabo/jumpers-macho-macho-x40-cabos)
15 | Placa Nano V3 + Cabo USB | RoboCore | 1 | R$28.90 |  |  | 0 | Abrir Produto (https://www.robocore.net/placa-arduino/placa-nano-v3-com-cabo-usb-para-arduino)
16 | Placa ESP32-S3 CAM N16R8 + Câmera OV5640 5MP | Mercado Livre | 1 | R$119.00 |  |  | 0 | Abrir Produto (https://www.mercadolivre.com.br/p/MLB2061307865?matt_tool=38524122&pdp_filters=item_id:MLB5139266661)
17 | Cartão MicroSD 32GB Sandisk Ultra A1 | Mercado Livre | 1 | R$49.90 |  |  | 0 | Abrir Produto (https://www.mercadolivre.com.br/cartao-de-memoria-micro-sd-sandisk-ultra-32gb-120mbs-c10-a1/p/MLB20654826)
18 | Módulo Giroscópio MPU-6050 GY-521 (VR) | Mercado Livre | 1 | R$19.90 |  |  | 1 | Abrir Produto (https://www.mercadolivre.com.br/modulo-acelerometro-giroscopio-mpu6050-gy521/up/MLBU4448831937)
 | Total Essencial (sem opcionais) - à vista no PIX
 | TOTAL GERAL (com opcionais) - à vista no PIX

Sheet: Rover Raspberry Pi 3
Item | Produto | Loja | Qtd | Preço Unitário (R$) | Preço à Vista PIX (R$) | Subtotal à Vista (R$) | Opcional (0/1) | Link Direto
1 | Micro Servo 9g SG90 (TowerPro) | RoboCore | 2 | R$13.67 |  |  | 0 | Abrir Produto (https://www.robocore.net/atuador/micro-servo-9g-sg90-towerpro)
2 | Câmera para Raspberry Pi Rev 1.3 (5MP) | RoboCore | 1 | R$49.90 |  |  | 0 | Abrir Produto (https://www.robocore.net/acessorios-raspberry-pi/camera-para-raspberry-pi-rev-1-3)
3 | Suporte Pan/Tilt para Câmera Raspberry Pi | RoboCore | 1 | R$6.90 |  |  | 0 | Abrir Produto (https://www.robocore.net/item-mecanico/suporte-pan-tilt-para-camera-raspberry-pi)
4 | Micro Motor DC 6V 100RPM Redução Metal | RoboCore | 4 | R$29.90 |  |  | 0 | Abrir Produto (https://www.robocore.net/motor-caixas-de-reducao/micro-motor-com-caixa-de-reducao-6v-100rpm)
5 | StickyMAX - Roda S20 Macia 22mm | RoboCore | 4 | R$39.90 |  |  | 0 | Abrir Produto (https://www.robocore.net/roda/roda-stickymax-s20-22mm)
6 | Suporte para Micro Motores (Par Branco) | RoboCore | 2 | R$9.90 |  |  | 0 | Abrir Produto (https://www.robocore.net/item-mecanico/suporte-para-micro-motores)
7 | Módulo Driver Ponte H - L298N (Driver 1) | RoboCore | 1 | R$14.90 |  |  | 0 | Abrir Produto (https://www.robocore.net/driver-motor/driver-motor-ponte-h-l298n)
8 | Módulo Driver Ponte H - L298N (Driver 2) | RoboCore | 1 | R$14.90 |  |  | 0 | Abrir Produto (https://www.robocore.net/driver-motor/driver-motor-ponte-h-l298n)
9 | Conversor DC/DC Step Down Mini 560 5V (5A) | RoboCore | 1 | R$7.50 |  |  | 0 | Abrir Produto (https://www.robocore.net/regulador-de-tensao/conversor-dc-dc-step-down-mini-560-5v)
10 | Pack Bateria Li-Ion 7,4V 2500mAh com BMS | RoboCore | 1 | R$69.90 |  |  | 0 | Abrir Produto (https://www.robocore.net/baterias-fontes/pack-bateria-li-ion-7_4v-2500mah-com-bms)
11 | Cabo JST-RCY 2 pinos Fêmea | RoboCore | 1 | R$1.90 |  |  | 0 | Abrir Produto (https://www.robocore.net/cabo/cabo-jst-rcy-2-pinos-femea)
12 | Módulo Buzzer 5V Passivo | RoboCore | 1 | R$4.90 |  |  | 1 | Abrir Produto (https://www.robocore.net/atuador/modulo-buzzer-5v-passivo)
13 | Módulo WS2812 LED RGB (Barra 8 LEDs) | RoboCore | 1 | R$9.90 |  |  | 1 | Abrir Produto (https://www.robocore.net/led/modulo-ws2812-led-enderecavel-8-leds)
14 | Chave Gangorra KCD1-101 2T | RoboCore | 1 | R$1.50 |  |  | 0 | Abrir Produto (https://www.robocore.net/botao-chave/chave-gangorra-kcd1-101-2t)
15 | Jumpers Fêmea-Fêmea x40 Unidades | RoboCore | 1 | R$6.90 |  |  | 0 | Abrir Produto (https://www.robocore.net/cabo/jumpers-femea-femea-x40-unidades)
16 | Jumpers Macho-Macho x40 Cabos | RoboCore | 1 | R$7.90 |  |  | 0 | Abrir Produto (https://www.robocore.net/cabo/jumpers-macho-macho-x40-cabos)
17 | Placa Nano V3 + Cabo USB | RoboCore | 1 | R$28.90 |  |  | 0 | Abrir Produto (https://www.robocore.net/placa-arduino/placa-nano-v3-com-cabo-usb-para-arduino)
18 | Raspberry Pi 3 Model B (se não possuir) | Mercado Livre | 1 | R$389.00 |  |  | 0 | Abrir Produto (https://www.mercadolivre.com.br/raspberry-pi3-pi-3-model-b-quadcore-12ghz/p/MLB42963336)
19 | Cartão MicroSD 64GB Sandisk Ultra A1 Classe 10 | Mercado Livre | 1 | R$69.90 |  |  | 0 | Abrir Produto (https://www.mercadolivre.com.br/memoria-microsd-profissional-sandisk-ultra-64gb-120-mbs-a1/p/MLB23033439)
20 | Módulo Giroscópio MPU-6050 GY-521 (VR) | Mercado Livre | 1 | R$19.90 |  |  | 1 | Abrir Produto (https://www.mercadolivre.com.br/modulo-acelerometro-giroscopio-mpu6050-gy521/up/MLBU4448831937)
 | Total Essencial (sem opcionais) - à vista no PIX
 | TOTAL GERAL (com opcionais) - à vista no PIX
