CaioHVectorA/rover/LISTA_DE_COMPRAS_ROVER_ESP32.xlsx

Item | Produto | Loja | Qtd | Preco Unitario (R$) | Subtotal (R$) | Link
1 | Micro Servo 9g SG90 (TowerPro) | RoboCore | 2 | $13.67 |  | Link (https://www.robocore.net/atuador/micro-servo-9g-sg90-towerpro)
2 | Câmera para Raspberry Pi Rev 1.3 (5MP) | RoboCore | 1 | $49.90 |  | Link (https://www.robocore.net/acessorios-raspberry-pi/camera-para-raspberry-pi-rev-1-3)
3 | Suporte Pan/Tilt para Câmera Raspberry Pi | RoboCore | 1 | $6.90 |  | Link (https://www.robocore.net/item-mecanico/suporte-pan-tilt-para-camera-raspberry-pi)
4 | Micro Motor DC 6V 100RPM Reducao Metal | RoboCore | 4 | $29.90 |  | Link (https://www.robocore.net/motor-caixas-de-reducao/micro-motor-com-caixa-de-reducao-6v-100rpm)
5 | StickyMAX - Roda S20 Macia 22mm | RoboCore | 4 | $39.90 |  | Link (https://www.robocore.net/roda/roda-stickymax-s20-22mm)
6 | Suporte para Micro Motores (Par Branco) | RoboCore | 2 | $9.90 |  | Link (https://www.robocore.net/item-mecanico/suporte-para-micro-motores)
7 | Modulo Driver Ponte H - L298N (Driver 1) | RoboCore | 1 | $14.90 |  | Link (https://www.robocore.net/driver-motor/driver-motor-ponte-h-l298n)
8 | Modulo Driver Ponte H - L298N (Driver 2) | RoboCore | 1 | $14.90 |  | Link (https://www.robocore.net/driver-motor/driver-motor-ponte-h-l298n)
9 | Conversor DC/DC Step Down Mini 560 5V | RoboCore | 1 | $7.50 |  | Link (https://www.robocore.net/regulador-de-tensao/conversor-dc-dc-step-down-mini-560-5v)
10 | Pack Bateria Li-Ion 7,4V 2500mAh com BMS | RoboCore | 1 | $69.90 |  | Link (https://www.robocore.net/baterias-fontes/pack-bateria-li-ion-7_4v-2500mah-com-bms)
11 | Cabo JST-RCY 2 pinos Femea | RoboCore | 1 | $1.90 |  | Link (https://www.robocore.net/cabo/cabo-jst-rcy-2-pinos-femea)
12 | Modulo Buzzer 5V Passivo | RoboCore | 1 | $4.90 |  | Link (https://www.robocore.net/atuador/modulo-buzzer-5v-passivo)
13 | Modulo WS2812 LED RGB (Barra 8 LEDs) | RoboCore | 1 | $9.90 |  | Link (https://www.robocore.net/led/modulo-ws2812-led-enderecavel-8-leds)
14 | Chave Gangorra KCD1-101 2T | RoboCore | 1 | $1.50 |  | Link (https://www.robocore.net/botao-chave/chave-gangorra-kcd1-101-2t)
15 | Jumpers Femea-Femea x40 Unidades | RoboCore | 1 | $6.90 |  | Link (https://www.robocore.net/cabo/jumpers-femea-femea-x40-unidades)
16 | Jumpers Macho-Macho x40 Cabos | RoboCore | 1 | $7.90 |  | Link (https://www.robocore.net/cabo/jumpers-macho-macho-x40-cabos)
17 | Placa Nano V3 + Cabo USB | RoboCore | 1 | $28.90 |  | Link (https://www.robocore.net/placa-arduino/placa-nano-v3-com-cabo-usb-para-arduino)
18 | Raspberry Pi 3 Model B (se nao possuir) | Mercado Livre | 1 | $350.00 |  | Link (https://lista.mercadolivre.com.br/raspberry-pi-3)
19 | Cartao MicroSD 32GB Sandisk Ultra A1 Classe 10 | Mercado Livre | 1 | $39.90 |  | Link (https://lista.mercadolivre.com.br/cartao-sandisk-ultra-32gb-a1)
20 | Modulo Giroscopio MPU-6050 (VR Head Tracking) | Mercado Livre | 1 | $16.90 |  | Link (https://lista.mercadolivre.com.br/modulo-mpu6050)
 | Subtotal RoboCore (Itens 1 a 17)
 | RoboCore a vista no PIX (-5%)
 | Subtotal Mercado Livre (Itens 18 a 20)
 | TOTAL GERAL ESTIMADO (PIX RoboCore + ML)
