CaioHVectorA/rover/LISTA_DE_COMPRAS_ROVER_ESP32_RESTAURADA.xlsx

Item | Produto | Loja | Qtd | Preco Unitario (R$) | Subtotal (R$) | Link Direto
1 | Micro Servo 9g SG90 (TowerPro) | RoboCore | 2 | $13.67 |  | Abrir Produto (https://www.robocore.net/atuador/micro-servo-9g-sg90-towerpro)
2 | Micro Motor DC 6V 100RPM Reducao Metal | RoboCore | 4 | $29.90 |  | Abrir Produto (https://www.robocore.net/motor-caixas-de-reducao/micro-motor-com-caixa-de-reducao-6v-100rpm)
3 | StickyMAX - Roda S20 Macia 22mm | RoboCore | 4 | $39.90 |  | Abrir Produto (https://www.robocore.net/roda/roda-stickymax-s20-22mm)
4 | Suporte para Micro Motores (Par Branco) | RoboCore | 2 | $9.90 |  | Abrir Produto (https://www.robocore.net/item-mecanico/suporte-para-micro-motores)
5 | Modulo Driver Ponte H - L298N (Driver 1: Motores Esq.) | RoboCore | 1 | $14.90 |  | Abrir Produto (https://www.robocore.net/driver-motor/driver-motor-ponte-h-l298n)
6 | Modulo Driver Ponte H - L298N (Driver 2: Motores Dir.) | RoboCore | 1 | $14.90 |  | Abrir Produto (https://www.robocore.net/driver-motor/driver-motor-ponte-h-l298n)
7 | Conversor DC/DC Step Down Mini 560 5V (5A sincrono) | RoboCore | 1 | $7.50 |  | Abrir Produto (https://www.robocore.net/regulador-de-tensao/conversor-dc-dc-step-down-mini-560-5v)
8 | Pack Bateria Li-Ion 7,4V 2500mAh com BMS | RoboCore | 1 | $69.90 |  | Abrir Produto (https://www.robocore.net/baterias-fontes/pack-bateria-li-ion-7_4v-2500mah-com-bms)
9 | Cabo JST-RCY 2 pinos Femea | RoboCore | 1 | $1.90 |  | Abrir Produto (https://www.robocore.net/cabo/cabo-jst-rcy-2-pinos-femea)
10 | Modulo Buzzer 5V Passivo | RoboCore | 1 | $4.90 |  | Abrir Produto (https://www.robocore.net/atuador/modulo-buzzer-5v-passivo)
11 | Modulo WS2812 LED RGB (Barra 8 LEDs) | RoboCore | 1 | $9.90 |  | Abrir Produto (https://www.robocore.net/led/modulo-ws2812-led-enderecavel-8-leds)
12 | Chave Gangorra KCD1-101 2T | RoboCore | 1 | $1.50 |  | Abrir Produto (https://www.robocore.net/botao-chave/chave-gangorra-kcd1-101-2t)
13 | Jumpers Femea-Femea x40 Unidades | RoboCore | 1 | $6.90 |  | Abrir Produto (https://www.robocore.net/cabo/jumpers-femea-femea-x40-unidades)
14 | Jumpers Macho-Macho x40 Cabos | RoboCore | 1 | $7.90 |  | Abrir Produto (https://www.robocore.net/cabo/jumpers-macho-macho-x40-cabos)
15 | Placa Nano V3 + Cabo USB | RoboCore | 1 | $28.90 |  | Abrir Produto (https://www.robocore.net/placa-arduino/placa-nano-v3-com-cabo-usb-para-arduino)
16 | Placa ESP32-S3 CAM N16R8 + Camera OV5640 5MP | Mercado Livre | 1 | $119.00 |  | Abrir Produto (https://www.mercadolivre.com.br/p/MLB2061307865?matt_tool=38524122&pdp_filters=item_id:MLB5139266661)
17 | Cartao MicroSD 32GB Sandisk Ultra A1 (FAT32 p/ ESP32) | Mercado Livre | 1 | $49.90 |  | Abrir Produto (https://www.mercadolivre.com.br/cartao-de-memoria-micro-sd-sandisk-ultra-32gb-120mbs-c10-a1/p/MLB20654826)
18 | Modulo Giroscopio MPU-6050 GY-521 (VR Head Tracking) | Mercado Livre | 1 | $19.90 |  | Abrir Produto (https://www.mercadolivre.com.br/modulo-acelerometro-giroscopio-mpu6050-gy521/up/MLBU4448831937)
 | Subtotal RoboCore (Itens 1 a 15)
 | RoboCore a vista no PIX (-5%)
 | Subtotal Mercado Livre (Itens 16 a 18)
 | TOTAL GERAL ESTIMADO (PIX RoboCore + ML)
