CaioHVectorA/rover/docs/hardware/tabela_pinagem_esp32_nano.xlsx

Sheet: S3_CAM_Sem_Nano
Pino Físico | Silk na Placa | GPIO Nativo | Ligação | Uso | Suporta PWM? | ADC (Analógico) | Nível Lógico | Boot / Strapping | Observações
J1-01 (Esq) | 3V3 | - | Interno | Saída Regulada 3.3V | Não | Não | 3.3V | Normal
J1-02 (Esq) | GND | - | Fio Externo | GND Comum (Chassi e Sensores) | Não | Não | 0V (GND) | Normal
J1-03 (Esq) | IO1 | GPIO 1 | Fio Externo | Leitura Bateria 2S (Divisor 100k/33k) | Sim (LEDC/MCPWM) | ADC1_CH0 (Lê c/ Wi-Fi) | 3.3V | Touch 1
J1-04 (Esq) | IO2 | GPIO 2 | Fio Externo | LEDs WS2812B (Sinal DIN) | Sim (LEDC/MCPWM) | ADC1_CH1 (Lê c/ Wi-Fi) | 3.3V | Touch 2
J1-05 (Esq) | IO3 | GPIO 3 | Fio Externo | Servo Tilt (PWM 50Hz) | Sim (LEDC/MCPWM) | ADC1_CH2 (Lê c/ Wi-Fi) | 3.3V | JTAG / Touch 3
J1-06 (Esq) | IO41 | GPIO 41 | Fio Externo | Motor Esq AIN1 (TB6612 PWM) | Sim (LEDC/MCPWM) | Não | 3.3V | Normal
J1-07 (Esq) | IO42 | GPIO 42 | Fio Externo | Motor Esq AIN2 (TB6612 PWM) | Sim (LEDC/MCPWM) | Não | 3.3V | Normal
J1-08 (Esq) | TX (U0T) | GPIO 43 | Fio Externo | Motor Dir BIN1 (TB6612 PWM) | Sim (LEDC/MCPWM) | Não | 3.3V | U0TXD
J1-09 (Esq) | RX (U0R) | GPIO 44 | Fio Externo | Motor Dir BIN2 (TB6612 PWM) | Sim (LEDC/MCPWM) | Não | 3.3V | U0RXD
J1-10 (Esq) | IO19 | GPIO 19 | Interno | USB-C Nativo (D-) | Sim (LEDC/MCPWM) | ADC2_CH8 | 3.3V | USB D-
J1-11 (Esq) | IO20 | GPIO 20 | Interno | USB-C Nativo (D+) | Sim (LEDC/MCPWM) | ADC2_CH9 | 3.3V | USB D+
J1-12 (Esq) | IO21 | GPIO 21 | Fio Externo | Servo Pan (PWM 50Hz) | Sim (LEDC/MCPWM) | Não | 3.3V | Normal
J2-01 (Dir) | 5V | - | Fio Externo | Alimentação 5.0V (Vem do Mini 560) | Não | Não | 5.0V | Normal
J2-02 (Dir) | GND | - | Interno | GND Auxiliar Onboard | Não | Não | 0V (GND) | Normal
J2-03 (Dir) | IO0 | GPIO 0 | Interno | Botão BOOT Onboard | Sim (LEDC/MCPWM) | Não | 3.3V | Boot (Pull-up)
J2-04 (Dir) | IO4 | GPIO 4 | Interno | Câmera OV5640 (SIOD / SDA) | Sim (LEDC/MCPWM) | ADC1_CH3 | 3.3V | I2C Câmera
J2-05 (Dir) | IO5 | GPIO 5 | Interno | Câmera OV5640 (SIOC / SCL) | Sim (LEDC/MCPWM) | ADC1_CH4 | 3.3V | I2C Câmera
J2-06 (Dir) | IO6 | GPIO 6 | Interno | Câmera OV5640 (VSYNC) | Sim (LEDC/MCPWM) | ADC1_CH5 | 3.3V | Sinc Câmera
J2-07 (Dir) | IO7 | GPIO 7 | Interno | Câmera OV5640 (HREF) | Sim (LEDC/MCPWM) | ADC1_CH6 | 3.3V | Ref Câmera
J2-08 (Dir) | IO8 | GPIO 8 | Interno | Câmera OV5640 (D2) | Sim (LEDC/MCPWM) | ADC1_CH7 | 3.3V | Dados Câmera
J2-09 (Dir) | IO9 | GPIO 9 | Interno | Câmera OV5640 (D1) | Sim (LEDC/MCPWM) | ADC1_CH8 | 3.3V | Dados Câmera
J2-10 (Dir) | IO10 | GPIO 10 | Interno | Câmera OV5640 (D3) | Sim (LEDC/MCPWM) | ADC1_CH9 | 3.3V | Dados Câmera
J2-11 (Dir) | IO11 | GPIO 11 | Interno | Câmera OV5640 (D0) | Sim (LEDC/MCPWM) | ADC2_CH0 | 3.3V | Dados Câmera
J2-12 (Dir) | GND | - | Interno | GND Auxiliar Onboard | Não | Não | 0V (GND) | Normal

Sheet: S3_CAM_Com_Nano
Pino Físico | Silk na Placa | GPIO Nativo | Ligação | Uso | Suporta PWM? | ADC (Analógico) | Nível Lógico | Boot / Strapping | Observações
J1-01 (Esq) | 3V3 | - | Interno | Saída Regulada 3.3V | Não | Não | 3.3V | Normal
J1-02 (Esq) | GND | - | Fio Externo | GND Comum (Chicote Fio 2) | Não | Não | 0V (GND) | Normal
J1-03 (Esq) | IO1 | GPIO 1 |  |  | Sim (LEDC/MCPWM) | ADC1_CH0 (Lê c/ Wi-Fi) | 3.3V | Touch 1 (Livre)
J1-04 (Esq) | IO2 | GPIO 2 |  |  | Sim (LEDC/MCPWM) | ADC1_CH1 (Lê c/ Wi-Fi) | 3.3V | Touch 2 (Livre)
J1-05 (Esq) | IO3 | GPIO 3 |  |  | Sim (LEDC/MCPWM) | ADC1_CH2 (Lê c/ Wi-Fi) | 3.3V | Touch 3 (Livre)
J1-06 (Esq) | IO41 | GPIO 41 |  |  | Sim (LEDC/MCPWM) | Não | 3.3V | Livre p/ Expansão
J1-07 (Esq) | IO42 | GPIO 42 |  |  | Sim (LEDC/MCPWM) | Não | 3.3V | Livre p/ Expansão
J1-08 (Esq) | TX (U0T) | GPIO 43 | Fio Externo | Comandos -> Nano RX (Chicote Fio 3) | Sim (LEDC/MCPWM) | Não | 3.3V | U0TXD Serial
J1-09 (Esq) | RX (U0R) | GPIO 44 |  |  | Sim (LEDC/MCPWM) | Não | 3.3V | Livre (Simplex)
J1-10 (Esq) | IO19 | GPIO 19 | Interno | USB-C Nativo (D-) | Sim (LEDC/MCPWM) | ADC2_CH8 | 3.3V | USB D-
J1-11 (Esq) | IO20 | GPIO 20 | Interno | USB-C Nativo (D+) | Sim (LEDC/MCPWM) | ADC2_CH9 | 3.3V | USB D+
J1-12 (Esq) | IO21 | GPIO 21 |  |  | Sim (LEDC/MCPWM) | Não | 3.3V | Livre p/ Expansão
J2-01 (Dir) | 5V | - | Fio Externo | Alimentação 5.0V (Chicote Fio 1) | Não | Não | 5.0V | Normal
J2-02 (Dir) | GND | - | Interno | GND Auxiliar Onboard | Não | Não | 0V (GND) | Normal
J2-03 (Dir) | IO0 | GPIO 0 | Interno | Botão BOOT Onboard | Sim (LEDC/MCPWM) | Não | 3.3V | Boot (Pull-up)
J2-04 (Dir) | IO4 | GPIO 4 | Interno | Câmera OV5640 (SIOD / SDA) | Sim (LEDC/MCPWM) | ADC1_CH3 | 3.3V | I2C Câmera
J2-05 (Dir) | IO5 | GPIO 5 | Interno | Câmera OV5640 (SIOC / SCL) | Sim (LEDC/MCPWM) | ADC1_CH4 | 3.3V | I2C Câmera
J2-06 (Dir) | IO6 | GPIO 6 | Interno | Câmera OV5640 (VSYNC) | Sim (LEDC/MCPWM) | ADC1_CH5 | 3.3V | Sinc Câmera
J2-07 (Dir) | IO7 | GPIO 7 | Interno | Câmera OV5640 (HREF) | Sim (LEDC/MCPWM) | ADC1_CH6 | 3.3V | Ref Câmera
J2-08 (Dir) | IO8 | GPIO 8 | Interno | Câmera OV5640 (D2) | Sim (LEDC/MCPWM) | ADC1_CH7 | 3.3V | Dados Câmera
J2-09 (Dir) | IO9 | GPIO 9 | Interno | Câmera OV5640 (D1) | Sim (LEDC/MCPWM) | ADC1_CH8 | 3.3V | Dados Câmera
J2-10 (Dir) | IO10 | GPIO 10 | Interno | Câmera OV5640 (D3) | Sim (LEDC/MCPWM) | ADC1_CH9 | 3.3V | Dados Câmera
J2-11 (Dir) | IO11 | GPIO 11 | Interno | Câmera OV5640 (D0) | Sim (LEDC/MCPWM) | ADC2_CH0 | 3.3V | Dados Câmera
J2-12 (Dir) | GND | - | Interno | GND Auxiliar Onboard | Não | Não | 0V (GND) | Normal

Sheet: ESP32_CAM_RoboCore
Pino Físico | Silk na Placa | GPIO Nativo | Ligação | Uso | Suporta PWM? | ADC (Analógico) | Nível Lógico | Boot / Strapping | Observações
P01 (Header Esq) | 5V | - | Fio Externo | Alimentação 5.0V (Chicote Fio 1) | Não | Não | 5.0V | Normal
P02 (Header Esq) | GND | - | Fio Externo | GND Comum (Chicote Fio 2) | Não | Não | 0V (GND) | Normal
P03 (Header Esq) | IO12 | GPIO 12 | Interno | MicroSD (Data 2) | Sim (LEDC) | ADC2_CH5 (Incompatível c/ Wi-Fi) | 3.3V | Boot Strapping (Pull-down)
P04 (Header Esq) | IO13 | GPIO 13 | Interno | MicroSD (Data 3) | Sim (LEDC) | ADC2_CH4 (Incompatível c/ Wi-Fi) | 3.3V | Normal
P05 (Header Esq) | IO15 | GPIO 15 | Interno | MicroSD (CMD) | Sim (LEDC) | ADC2_CH3 (Incompatível c/ Wi-Fi) | 3.3V | Gera pulso no boot
P06 (Header Esq) | IO14 | GPIO 14 | Interno | MicroSD (CLK) | Sim (LEDC) | ADC2_CH6 (Incompatível c/ Wi-Fi) | 3.3V | Normal
P07 (Header Esq) | IO2 | GPIO 2 | Interno | LED Onboard (Azul) | Sim (LEDC) | ADC2_CH2 (Incompatível c/ Wi-Fi) | 3.3V | Boot Strapping (Pull-down)
P08 (Header Esq) | IO4 | GPIO 4 | Interno | Flash LED Alta Potência | Sim (LEDC) | ADC2_CH0 (Incompatível c/ Wi-Fi) | 3.3V | Trilha transistor Flash
P09 (Header Dir) | 3V3 | - | Interno | Saída Regulada 3.3V | Não | Não | 3.3V | Normal (~50mA max)
P10 (Header Dir) | GND | - | Interno | GND Auxiliar Onboard | Não | Não | 0V (GND) | Normal
P11 (Header Dir) | IO16 | GPIO 16 |  |  | Sim (LEDC) | Não | 3.3V | 100% Livre (Sem ADC)
P12 (Header Dir) | IO0 | GPIO 0 | Interno | Câmera (XCLK 20MHz) / Boot | Sim (LEDC) | ADC2_CH1 | 3.3V | Bootloader (Pull-up)
P13 (Header Dir) | U0R | GPIO 3 |  |  | Sim (LEDC) | Não | 3.3V | RX0 Serial (Livre no Simplex)
P14 (Header Dir) | U0T | GPIO 1 | Fio Externo | Comandos -> Nano RX (Chicote Fio 3) | Sim (LEDC) | Não | 3.3V | TX0 Serial
P15 (Header Dir) | GND | - | Interno | GND Auxiliar Onboard | Não | Não | 0V (GND) | Normal
P16 (Header Dir) | VCC | - | Interno | VCC Auxiliar Onboard | Não | Não | 5.0V / 3.3V | Normal

Sheet: Arduino_Nano_Chassi
Pino Físico | Silk na Placa | GPIO Nativo | Ligação | Uso | Suporta PWM? | ADC (Analógico) | Nível Lógico | Boot / Strapping | Observações
P01 (D0) | RX0 | PD0 | Fio Externo | Comandos <- ESP TX (Chicote Fio 3) | Não | Não | 5.0V | Serial RX (3.3V TTL direto)
P02 (D1) | TX1 | PD1 |  |  | Não | Não | 5.0V | Serial TX (Livre no Simplex)
P03 (D2) | D2 | PD2 |  |  | Não | Não | 5.0V | Interrupção Externa INT0 (Livre)
P04 (D3) | D3 | PD3 | Fio Externo | Motor Esq PWMA (Velocidade) | Sim (Timer 2 - 8-bit) | Não | 5.0V | PWM Hardware (490Hz)
P05 (D4) | D4 | PD4 | Fio Externo | Motor Esq AIN1 (Direção) | Não | Não | 5.0V | Sentido Giro Esq
P06 (D5) | D5 | PD5 | Fio Externo | Motor Esq AIN2 (Direção) | Sim (Timer 0 - 8-bit) | Não | 5.0V | Sentido Giro Esq
P07 (D6) | D6 | PD6 | Fio Externo | Motor Dir PWMB (Velocidade) | Sim (Timer 0 - 8-bit) | Não | 5.0V | PWM Hardware (980Hz)
P08 (D7) | D7 | PD7 | Fio Externo | Motor Dir BIN1 (Direção) | Não | Não | 5.0V | Sentido Giro Dir
P09 (D8) | D8 | PB0 | Fio Externo | Motor Dir BIN2 (Direção) | Não | Não | 5.0V | Sentido Giro Dir
P10 (D9) | D9 | PB1 | Fio Externo | Servo Pan Horizontal (Sinal) | Sim (Timer 1 - 16-bit) | Não | 5.0V | PWM Servo 50Hz Alta Precisão
P11 (D10) | D10 | PB2 | Fio Externo | Servo Tilt Vertical (Sinal) | Sim (Timer 1 - 16-bit) | Não | 5.0V | PWM Servo 50Hz Alta Precisão
P12 (D11) | D11 | PB3 | Fio Externo | Barra 8 LEDs WS2812B (Sinal DIN) | Sim (Timer 2 - 8-bit) | Não | 5.0V | Timing Crítico 800kHz (MOSI)
P13 (D12) | D12 | PB4 | Fio Externo | Buzzer Passivo (Sinal Beep) | Não | Não | 5.0V | Frequência tone() (MISO)
P14 (D13) | D13 | PB5 | Interno | LED L Onboard (Amarelo) | Não | Não | 5.0V | SPI SCK Onboard
P15 (A0) | A0 | PC0 | Fio Externo | Leitura Tensão Bateria 2S | Não | Sim (ADC0 10-bit 0-5V) | 5.0V | Divisor Resistivo (100k/47k)
P16 (A1) | A1 | PC1 |  |  | Não | Sim (ADC1 10-bit 0-5V) | 5.0V | Livre p/ Sensor Analógico
P17 (A2) | A2 | PC2 |  |  | Não | Sim (ADC2 10-bit 0-5V) | 5.0V | Livre p/ Sensor Analógico
P18 (A3) | A3 | PC3 |  |  | Não | Sim (ADC3 10-bit 0-5V) | 5.0V | Livre p/ Sensor Analógico
P19 (A4) | A4 | PC4 |  |  | Não | Sim (ADC4 10-bit 0-5V) | 5.0V | I2C SDA (Livre p/ IMU MPU6050)
P20 (A5) | A5 | PC5 |  |  | Não | Sim (ADC5 10-bit 0-5V) | 5.0V | I2C SCL (Livre p/ IMU MPU6050)
P21 (A6) | A6 | - |  |  | Não | Sim (ADC6 10-bit 0-5V) | 5.0V | Entrada Analógica Pura (Livre)
P22 (A7) | A7 | - |  |  | Não | Sim (ADC7 10-bit 0-5V) | 5.0V | Entrada Analógica Pura (Livre)
P23 (PWR) | 5V | - | Fio Externo | Alimentação 5.0V (Vem do Step-Down) | Não | Não | 5.0V | Entrada 5.0V Regulada
P24 (PWR) | GND | - | Fio Externo | GND Comum do Chassi | Não | Não | 0V (GND) | Terra Comum

Sheet: v2_2esps
Silk no ESP | GPIO | Tipo | Uso na PCB / KiCad | Status | Observações
3V3 | - | Alimentação | Saída 3.3V (Lógica PCB) | OCUPADO (Energia) | Alimenta TB6612, OLED, Mic e Temp
GND | - | Terra | GND Comum (Malha de Terra) | OCUPADO (Terra) | Terra comum de toda a placa
D15 | GPIO 15 | Áudio I2S | WS (MAX98357A + INMP441) | OCUPADO (Áudio) | Clock de palavra compartilhado
D2 | GPIO 2 | Digital/PWM | Barra 8 LEDs WS2812B (Sinal DIN) | OCUPADO (LEDs) | Conector J_LED (Farol/Status)
D4 | GPIO 4 | OneWire | TEMP-DATA (DS18B20) | OCUPADO (Sensor) | Resistor pull-up 4.7k no 3.3V
RX2 | GPIO 16 | Digital I/O |  |  | Livre para expansão
TX2 | GPIO 17 | Áudio I2S | DIN (MAX98357A externo) | OCUPADO (Áudio) | GPIO17 no pino 5 do chicote U4
D5 | GPIO 5 | Áudio I2S | BCLK (MAX98357A + INMP441) | OCUPADO (Áudio) | Clock de bits compartilhado
D18 | GPIO 18 | PWM | SERVO-PAN (Conector J4) | OCUPADO (Servo) | Servo Pan (Giro horizontal)
D19 | GPIO 19 | PWM | SERVO-TILT (Conector J5) | OCUPADO (Servo) | Servo Tilt (Inclinação vertical)
D21 | GPIO 21 | I2C SDA | OLED-SDA (Conector J_OLED) | OCUPADO (Display) | Display OLED 0.96"
RX0 | GPIO 3 | Serial USB |  |  | Livre para gravação / USB
TX0 | GPIO 1 | Serial USB |  |  | Livre para gravação / USB
D22 | GPIO 22 | I2C SCL | OLED-SCL (Conector J_OLED) | OCUPADO (Display) | Display OLED 0.96"
D23 | GPIO 23 | Digital I/O |  |  | Livre para expansão
EN | - | Reset |  |  | Botão Reset onboard
VP | GPIO 36 | Analógico |  |  | Livre (Entrada analógica ADC1)
VN | GPIO 39 | Analógico |  |  | Livre (Entrada analógica ADC1)
D34 | GPIO 34 | Analógico | VBAT-SENSE (Divisor Bateria) | OCUPADO (Bateria) | Divisor R3 10k / R4 4.7k
D35 | GPIO 35 | Áudio I2S | SD (Microfone INMP441) | OCUPADO (Áudio) | Microfone interno opcional em U5
D32 | GPIO 32 | PWM | PWMA (TB6612FNG) | OCUPADO (Motor) | Velocidade motores esquerdos
D33 | GPIO 33 | Digital | AIN1 (TB6612FNG) | OCUPADO (Motor) | Sentido motores esquerdos
D25 | GPIO 25 | Digital | AIN2 (TB6612FNG) | OCUPADO (Motor) | Sentido motores esquerdos
D26 | GPIO 26 | PWM | PWMB (TB6612FNG) | OCUPADO (Motor) | Velocidade motores direitos
D27 | GPIO 27 | Digital | BIN1 (TB6612FNG) | OCUPADO (Motor) | Sentido motores direitos
D14 | GPIO 14 | Digital | BIN2 (TB6612FNG) | OCUPADO (Motor) | Sentido motores direitos
D12 | GPIO 12 | Boot | NÃO CONECTAR (NC) | OCUPADO (Proteção) | Trava boot se puxado p/ HIGH
D13 | GPIO 13 | Digital | STBY (TB6612FNG) | OCUPADO (Motor) | Habilita ponte H (HIGH = Ativo)
GND | - | Terra | GND Comum (Malha de Terra) | OCUPADO (Terra) | Terra comum de toda a placa
VIN | - | Alimentação | Entrada +5.0V (Step-Down) | OCUPADO (Energia) | Recebe 5V do Mini 560
Conector | Pinos | Ligação no Robô | Sinal / Função dos Pinos
J1 (Bateria) | 2 pinos | Bateria 2S (via Chave Geral) | Pino 1 = VCC BAT (7.4V a 8.4V) | Pino 2 = GND
J2 (Câmera) | 2 pinos | Chicote p/ Cabeça Pan/Tilt | Pino 1 = +5.0V | Pino 2 = GND (Câmera opera via Wi-Fi)
J4 (Servo Pan) | 3 pinos | Micro Servo SG90 (Pan) | 1 = GND | 2 = +5 V | 3 = PAN (GPIO18)
J5 (Servo Tilt) | 3 pinos | Micro Servo SG90 (Tilt) | 1 = GND | 2 = +5 V | 3 = TILT (GPIO19)
J7 (WS2812B) | 3 pinos | Barra 8 LEDs RGB | Pino 1 = +5.0V | Pino 2 = Sinal DIN (D2) | Pino 3 = GND
J9 (OLED externo) | 4 pinos | Chicote para OLED SSD1306 externo | Pino 1 = GND | Pino 2 = 3V3 | Pino 3 = SCL (D22) | Pino 4 = SDA (D21)
J3 (Motores E) | 2 pinos | 2x Motores Esquerdos JGA-050 | Saídas AO1 e AO2 do TB6612FNG (em paralelo)
J6 (Motores D) | 2 pinos | 2x Motores Direitos JGA-050 | Saídas BO1 e BO2 do TB6612FNG (em paralelo)
