CaioHVectorA/rover/docs/hardware/compras_rover_reorganizado_atualizado.xlsx

Sheet: Resumo Geral
ROVER ESP32-S3 4WD — PLANEJAMENTO CONSOLIDADO DE COMPRAS
Revisado em 13/10/2026. Totais incluem estimativas do ML; compra ainda tem pendências.
TOTAL COM ESTIMATIVAS |  | À VISTA COM ESTIMATIVAS |  | ECONOMIA TOTAL À VISTA
CONSOLIDAÇÃO POR FORNECEDOR / LOJA
Loja / Plataforma | Escopo dos Componentes | Desconto À Vista | Subtotal Cartão | Subtotal Pix/Boleto | Economia
UsinaInfo | Bancada térmica, telemetria, antena 3dBi, display e controle
Mercado Livre | microSD, LEDs e receptor: recotar Full; valores estimados
Curto Circuito | Módulo 4G LTE Cat-4 A7608SA-H (teleoperação remota)
Total Consolidado
INVESTIMENTO POR CATEGORIA DE PRIORIDADE
Prioridade | Objetivo / Abrangência | Total Cartão | Total Pix/Boleto | Participação
Alta | Térmica, tensão, antena condicional e 4G futuro
Média | Display OLED de bateria (UsinaInfo)
Baixa | Controle futuro + itens ML ainda estimados
Total Consolidado
Compra pendente | 3 anúncios ML sem Full confirmado. Antena e receptor dependem do modelo da placa/rádio.
Conjunto incompleto | Farol sem limitador/acionamento/dissipação. Controle precisa de microcontrolador. Thermal pad não cotado.
4G / bancada | Alimentação, interface, vídeo e encaixe do módulo ainda precisam de validação. Fretes e plano não incluídos.
Subtotal lojas diretas

Sheet: UsinaInfo
USINAINFO — COMPONENTES DE BANCADA, SENSORES & CONTROLE
Preços consultados em 13/10/2026. Montagem e compatibilidade ainda dependem de bancada.
Desconto Boleto / Pix: |  | 5% | (editável)
Código | Produto | Qtd | Unit. Cartão | Subtotal Cartão | À Vista (Pix/Boleto) | Link do Produto | Prioridade | Situação | Uso / Compatibilidade Técnica
07459 | Mini ventoinha 5V 25 × 25 × 10 mm | 1 | R$16.97 |  |  | Abrir produto (https://www.usinainfo.com.br/coolers-para-pc/mini-cooler-5v-25x25mm-para-esc-e-projetos-4408.html) | Alta | Em estoque | 5 V, 30–60 mA. Prever entrada/saída de ar. Ficha cita 25×25×10 mm; fotos mostram 7 mm: confirmar espessura.
06077 | DS18B20 — sensor de temperatura digital | 2 | R$15.34 |  |  | Abrir produto (https://www.usinainfo.com.br/sensor-de-temperatura/ds18b20-sensor-de-temperatura-digital-2806.html) | Alta | Em estoque | Componente avulso. Prever pull-up 4,7 kΩ e isolamento. Medir região quente da câmera e ambiente; não mede a junção.
07479 | Kit de 3 dissipadores autoadesivos | 1 | R$3.60 |  |  | Abrir produto (https://www.usinainfo.com.br/acessorios-raspberry-pi/kit-dissipador-de-calor-autoadesivo-raspberry-pi-3-pi-2-b-e-b-em-aluminio-3-unidades-4428.html) | Alta | Em estoque | 3 peças por kit. Confirmar dimensões, contato térmico e isolamento. Não garante resfriamento da OV5640.
06731 | Sensor de tensão DC 0–25 V (divisor 5:1) | 1 | R$4.95 |  |  | Abrir produto (https://www.usinainfo.com.br/sensor-de-tensao/sensor-de-tensao-dc-0-25v-3425.html) | Alta | Em estoque | Divisor 5:1 para A0 do Nano. Alternativa ao divisor já documentado. Calibrar; tensão não fornece % exata de carga.
08359 | Kit Antena Wi-Fi 2,4GHz 3dBi + Cabo Pigtail U.FL (IPEX1) para SMA Fêmea | 1 | R$11.80 |  |  | Abrir produto (https://www.usinainfo.com.br/transmissores-e-receptores/antena-esp8266-24ghz-3dbi-esp8266-external-antenna-cabo-pigtail-uflipx1-2mm-com-conector-sma-femea-525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) | Alta | Compatibilidade pendente | Kit completo: inclui a antena de 3dBi e o cabo adaptador Pigtail U.FL para rosca SMA fêmea.
08483 | Display OLED 0,96” I²C 128×64 (SSD1306) | 1 | R$24.30 |  |  | Abrir produto (https://www.usinainfo.com.br/display-arduino/display-oled-096-i2c-128x64-branco-5366.html) | Média | Em estoque | Nano: A4/A5. Conferir disponibilidade. SSD1306 com framebuffer usa 1 kB; preferir buffer de página U8g2 (U8g2 não é sempre leve).
08712 | Display TFT 1,3” ST7789 SPI 240×240 | 1 | R$34.70 |  |  | Abrir produto (https://www.usinainfo.com.br/display-arduino/display-tft-lcd-13-spi-rgb-240x240-st7789-5607.html) | Baixa | Em estoque | Controle futuro. Precisa de microcontrolador disponível no laboratório; TFT sozinho não recebe vídeo nem envia comandos.
05623 | Joystick analógico KY-023 / HW-504 | 2 | R$5.95 |  |  | Abrir produto (https://www.usinainfo.com.br/joystick-e-controles-ir/joystick-ky023-3-eixos-2305.html) | Baixa | Em estoque | Dois joysticks, cada um com dois eixos + botão. No ESP alimentar em 3,3 V; não conectar saídas 5 V ao ADC.
03741 | Conversor de nível lógico 3,3V / 5V bidirecional — CNL35 | 1 | R$7.50 |  |  | Abrir produto (https://www.usinainfo.com.br/conversores-de-sinal/conversor-de-nivel-logico-33-5v-bidirecional-cnl35-3741.html) | Alta | Em estoque | Adaptação 3,3 V (ESP32) ⇄ 5 V (Nano) para UART nativa a 115200 baud, eliminando o transistor BC337.
09989 | Display TFT LCD 3,5" SPI Touch Screen com Slot SD (ILI9488) | 1 | R$119.60 |  |  | Abrir produto (https://www.usinainfo.com.br/display-arduino/tft-lcd-35-spi-touch-screen-com-slot-sd-8570.html) | Alta | Em estoque | Display grande 480x320 com touch screen (XPT2046) e slot MicroSD, lógica nativa 3,3 V via SPI.
02989 | Push Button Chave Táctil 6x6x5mm (2x Kits com 5 un = 10 botões) | 2 | R$2.46 |  |  | Abrir produto (https://www.usinainfo.com.br/push-buttons/push-button-chave-tactil-6x6x5-kit-com-5-unidades-2989.html) | Alta | Em estoque | 10 chaves tácteis momentâneas para comandos físicos, reset, calibração e botões de interface.
 | Total dos itens cotados (UsinaInfo)
 | Subtotal Prioridade Alta (cotados)
 | Subtotal Prioridade Média (cotados)
 | Subtotal Prioridade Baixa (cotados)
Notas e Observações:
• ¹ Desconto à vista de 5% configurável na célula D5. Fretes não inclusos.
Preços dos 8 itens conferidos; sensor DC: valor consultado nesta sessão. Estoque pode mudar.
W5500 e ESP auxiliar ausentes nesta versão; controle futuro precisa de placa disponível no laboratório.
Thermal pad não consta nesta lista. Verificar espessura e área de contato antes de cotar.

Sheet: Mercado Livre
MERCADO LIVRE — COMPONENTES DE EXPANSÃO (PRIORIDADE BAIXA)
Ofertas ainda a recotar com vendedor e item específicos. Links atuais não comprovam Full.
Desconto Boleto / Pix: |  | 0% | (Preço padrão cartão/Pix)
Código | Produto | Qtd | Unit. estimado | Subtotal Cartão | À Vista (Pix/Boleto) | Link do Produto | Prioridade | Situação | Uso / Compatibilidade Técnica
ML-SD32 | Cartão microSD SanDisk Ultra 32GB Classe 10 + Adaptador | 1 | R$44.90 |  |  | Revisar anúncio (https://www.mercadolivre.com.br/cartao-de-memoria-sandisk-sdsqunr-032g-gn3ma-ultra-com-adaptador-sd-32gb/p/MLB14736452) | Baixa | A recotar Full | R$44,90 não confirmado. Link abriu a R$59 sem Full. Confirmar slot/firmware SD; gravação contínua não implementada/validada.
ML-LED3W | Kit 10x LEDs 3W Branco Frio 6000K c/ Base Estrela | 1 | R$29.90 |  |  | Revisar anúncio (https://www.mercadolivre.com.br/kit-10-unidades-de-led-avulso-3w--moeda-estrela-branco-6000k/up/MLBU3658842164) | Baixa | A recotar Full | R$29,90 não confirmado; anúncio abriu a R$70,13 sem Full confirmado. Corrente não validada. Farol exige limitador, PWM e dissipação dedicada.
ML-FSIA6B | Receptor FlySky FS-iA6B 6CH 2.4GHz AFHDS 2A | 1 | R$79.90 |  |  | Revisar anúncio (https://www.mercadolivre.com.br/receiver-dtxmx-flysky-fs-ia6b-24g-6-channels-for-fs-i6/p/MLB2071280071) | Baixa | Importado; não elegível | Preço estimado sem cotação elegível. AFHDS 2A: confirmar modelo do FlySky. Marca/procedência do anúncio não comprovam receptor oficial. Integrar ao Nano + failsafe.
ML-MAX98357A | Módulo amplificador I2S MAX98357A + Mini alto-falante 3W | 1 | R$25.00 |  |  | Revisar anúncio (https://lista.mercadolivre.com.br/modulo-max98357a) | Média | A recotar Full | DAC + amplificador Classe D 3,2 W via I2S nativo do ESP32 (3 pinos) para buzina real, efeitos sonoros e alertas.
 | Total estimado (não validado)
 | Subtotal prioridade média (estimado)
 | Subtotal prioridade baixa (estimado)
Notas e Observações ML:
Catálogo MLB/MLBU não garante Full. Registrar oferta, vendedor e Full na seção de compra.
Driver ausente: o farol só fica completo com limitação de corrente, acionamento e dissipação dimensionados.
Prioridades desta versão preservadas. Valores estimados mantidos; não são cotações aprovadas.

Sheet: Curto Circuito
CURTO CIRCUITO — EXPANSÃO TELEMETRIA 4G / LTE
Módulo LTE Cat-4 para expansão futura; ligação com a S3-CAM ainda a validar.
Desconto Boleto / Pix: |  | 10% | (editável)
Código | Produto | Qtd | Unit. Cartão | Subtotal Cartão | À Vista (Pix/Boleto) | Link do Produto | Prioridade | Situação | Uso / Compatibilidade Técnica
0000000018609 | Módulo A7608SA-H 4G LTE Cat-4 + Antena FCP | 1 | R$448.00 |  |  | Abrir produto (https://curtocircuito.com.br/modulo-a7608sa-h-4g-lte-antena-fcp.html) | Alta | Cotado; integração pendente | Placa 5–16 V, núcleo avulso 3,4–4,2 V. Reservar alimentação para picos; não assumir Mini-560 validado. USB/PPP, GPIO e vazão serial pendentes.
 | Total Curto Circuito
Notas e Observações:
• ¹ Desconto à vista de 10% da Curto Circuito configurável na célula D5.
• Frete e plano de dados móveis (M2M / IoT ou pré-pago) não inclusos no valor cotado.
ML R$427,51: sem Full confirmado; alternativa excluída pelo requisito do usuário.
Link Alternativa ML: | ML sem Full confirmado (https://www.mercadolivre.com.br/modulo-gsm-a7608sah-4g-lte-com-antena-fcp/up/MLBU2311204429)
