CaioHVectorA/rover/docs/compras/compras_rover_reorganizado_atualizado.xlsx

ROVER ESP32-S3 — PLANEJAMENTO DE COMPRAS (2º LOTE)
Planilha simplificada para visualização rápida no celular e computador.
TOTAL À VISTA (PIX) |  | TOTAL CARTÃO |  | ECONOMIA NO PIX
1. USINAINFO — SENSORES, TELAS, BOTÕES & REFRIGERAÇÃO (5% OFF NO PIX)
Produto / Componente | Qtd | Preço Unit. | Subtotal Cartão | À Vista (Pix) | Link de Compra
Display TFT LCD 3,5" SPI Touch + Slot SD (ILI9488) | 1 | R$119.60 |  |  | Abrir Loja ↗ (https://www.usinainfo.com.br/display-arduino/tft-lcd-35-spi-touch-screen-com-slot-sd-8570.html)
Display TFT 1,3” ST7789 SPI 240×240 (Econômico) | 1 | R$34.70 |  |  | Abrir Loja ↗ (https://www.usinainfo.com.br/display-arduino/display-tft-lcd-13-spi-rgb-240x240-st7789-5607.html)
Display OLED 0,96” I²C 128×64 (SSD1306) | 1 | R$24.30 |  |  | Abrir Loja ↗ (https://www.usinainfo.com.br/display-arduino/display-oled-096-i2c-128x64-branco-5366.html)
Push Button Chave Táctil 6×6×5mm (2x Kits c/ 5 = 10 botões) | 2 | R$2.46 |  |  | Abrir Loja ↗ (https://www.usinainfo.com.br/push-buttons/push-button-chave-tactil-6x6x5-kit-com-5-unidades-2989.html)
Kit 10 Capas para Push Button 6×6mm (Pretas/Brancas) | 1 | R$8.86 |  |  | Abrir Loja ↗ (https://www.usinainfo.com.br/push-buttons/capa-para-push-button-6x6mm-preta-kit-com-10-unidades-5861.html)
Conversor de Nível Lógico 3,3V / 5V Bidirecional (CNL35) | 1 | R$7.50 |  |  | Abrir Loja ↗ (https://www.usinainfo.com.br/conversores-de-sinal/conversor-de-nivel-logico-33-5v-bidirecional-cnl35-3741.html)
Kit Antena Wi-Fi 2,4GHz 3dBi + Cabo Pigtail U.FL (IPEX) | 1 | R$11.80 |  |  | Abrir Loja ↗ (https://www.usinainfo.com.br/antenas-wireless/antena-omni-wi-fi-24ghz-3dbi-com-pigtail-u-fl-ipex1-5259.html)
Mini Ventoinha 5V (25×25×10mm) | 1 | R$16.97 |  |  | Abrir Loja ↗ (https://www.usinainfo.com.br/coolers-para-pc/mini-cooler-5v-25x25mm-para-esc-e-projetos-4408.html)
2x Sensores de Temperatura DS18B20 | 2 | R$15.34 |  |  | Abrir Loja ↗ (https://www.usinainfo.com.br/sensores-de-temperatura/sensor-de-temperatura-ds18b20-avulso-2741.html)
Kit 3 Mini Dissipadores Autoadesivos | 1 | R$3.60 |  |  | Abrir Loja ↗ (https://www.usinainfo.com.br/dissipadores-de-calor/kit-com-3-dissipadores-de-aluminio-para-raspberry-pi-3-e-outros-4428.html)
Sensor de Tensão DC 0–25V (Divisor 5:1) | 1 | R$4.95 |  |  | Abrir Loja ↗ (https://www.usinainfo.com.br/sensor-de-tensao/sensor-de-tensao-dc-0-25v-3425.html)
2x Joysticks Analógicos KY-023 (Controle Futuro) | 2 | R$5.95 |  |  | Abrir Loja ↗ (https://www.usinainfo.com.br/joystick-e-controles-ir/joystick-ky023-3-eixos-2305.html)
Subtotal UsinaInfo (12 itens):
2. MERCADO LIVRE — ÁUDIO I2S, FARÓIS, MICROSD & RÁDIO (FRETE FULL)
Produto / Componente | Qtd | Preço Unit. | Subtotal Cartão | À Vista (Pix) | Link de Compra
Módulo Áudio I2S MAX98357A + Mini Alto-falante 3W | 1 | R$25.00 |  |  | Abrir ML ↗ (https://lista.mercadolivre.com.br/modulo-max98357a)
Cartão MicroSD SanDisk Ultra 32GB Classe 10 A1 | 1 | R$44.90 |  |  | Abrir ML ↗ (https://www.mercadolivre.com.br/cartao-de-memoria-micro-sd-sandisk-ultra-32gb-120mbs-c10-a1/p/MLB20654826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)
Kit 10x LEDs 3W Branco Frio Estrela (Faróis) | 1 | R$29.90 |  |  | Abrir ML ↗ (https://lista.mercadolivre.com.br/led-3w-estrela_OrderId_PRICE*ASC_Fulfillment_YES)
Receptor FlySky FS-iA6B 6CH 2.4GHz | 1 | R$79.90 |  |  | Abrir ML ↗ (https://lista.mercadolivre.com.br/fs-ia6b_OrderId_PRICE*ASC_Fulfillment_YES)
Subtotal Mercado Livre (4 itens):
3. CURTO CIRCUITO — EXPANSÃO 4G LTE (10% OFF NO PIX)
Produto / Componente | Qtd | Preço Unit. | Subtotal Cartão | À Vista (Pix) | Link de Compra
Módulo 4G LTE Cat-4 A7608SA-H + Antena FCP (Teleoperação) | 1 | R$448.00 |  |  | Abrir Loja ↗ (https://curtocircuito.com.br/modulo-a7608sa-h-4g-lte-antena-fcp.html)
Subtotal Curto Circuito (1 item):
TOTAL GERAL CONSOLIDADO:
