CaioHVectorA/rover/docs/hardware/kicad/rover_pcb_v2_chassi/modelos_3d/Mini560_volume_29x18x5p4.step

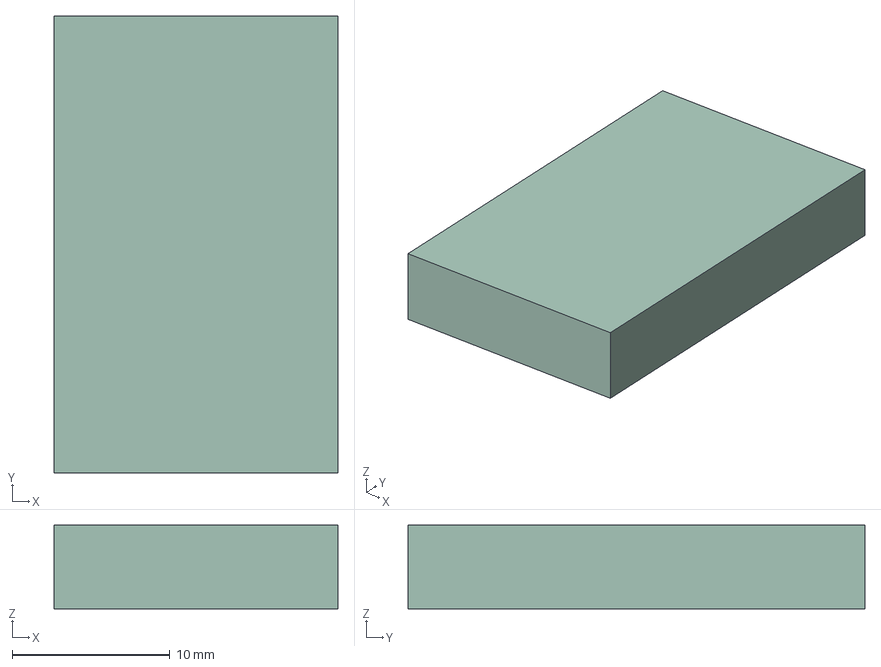
[picture p16: CAD file, 2026-11-11]
docs/hardware/kicad/rover_pcb_v2_chassi/modelos_3d/Mini560_volume_29x18x5p4.step
18.0 x 29.0 x 5.31 mm
