CaioHVectorA/rover/docs/hardware/kicad/rover_pcb_v2_chassi/modelos_3d/DevKit30_referencia.step

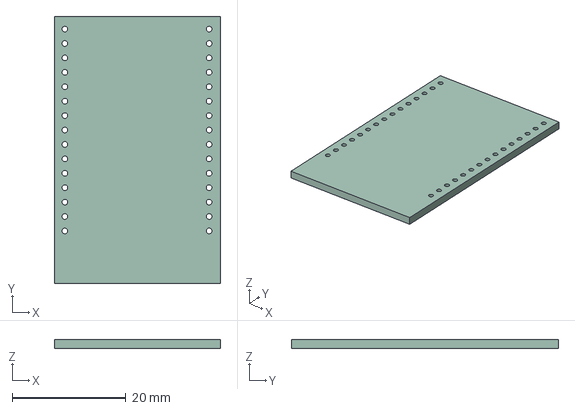
[picture p17: CAD file, 2026-11-11]
docs/hardware/kicad/rover_pcb_v2_chassi/modelos_3d/DevKit30_referencia.step
29.2 x 47.1 x 1.51 mm
