CaioHVectorA/rover/docs/hardware/kicad/rover_pcb_v2_chassi/modelos_3d/INMP441_portadora_referencia.step

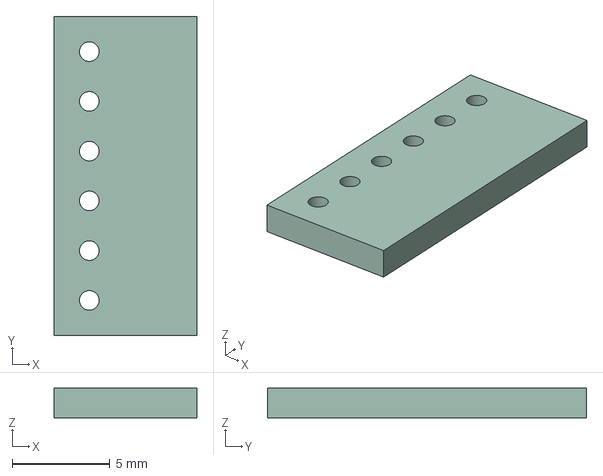
[picture p18: CAD file, 2026-11-11]
docs/hardware/kicad/rover_pcb_v2_chassi/modelos_3d/INMP441_portadora_referencia.step
7.30 x 16.3 x 1.51 mm
