CaioHVectorA/rover/docs/hardware/kicad/rover_pcb_v2_chassi/modelos_3d/TB6612_portadora_referencia.step

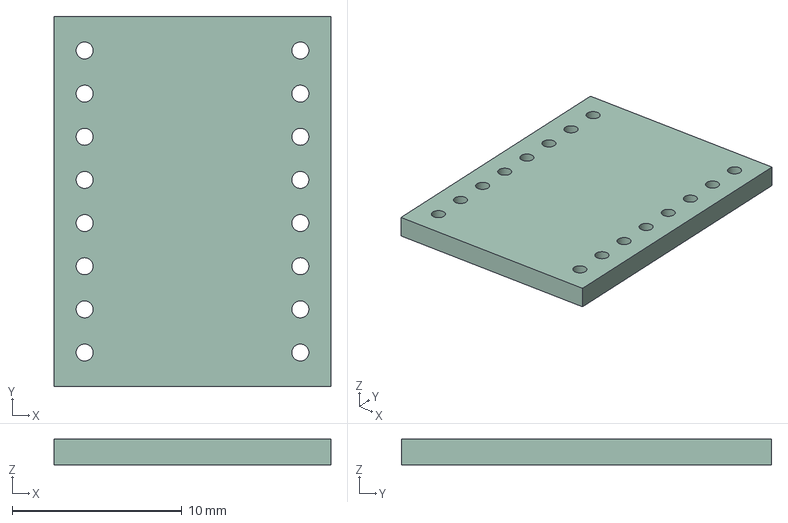
[picture p19: CAD file, 2026-11-11]
docs/hardware/kicad/rover_pcb_v2_chassi/modelos_3d/TB6612_portadora_referencia.step
16.3 x 21.8 x 1.51 mm
