CaioHVectorA/rover/docs/hardware/kicad/rover_perfurada_90x150/montagem_inferior.png

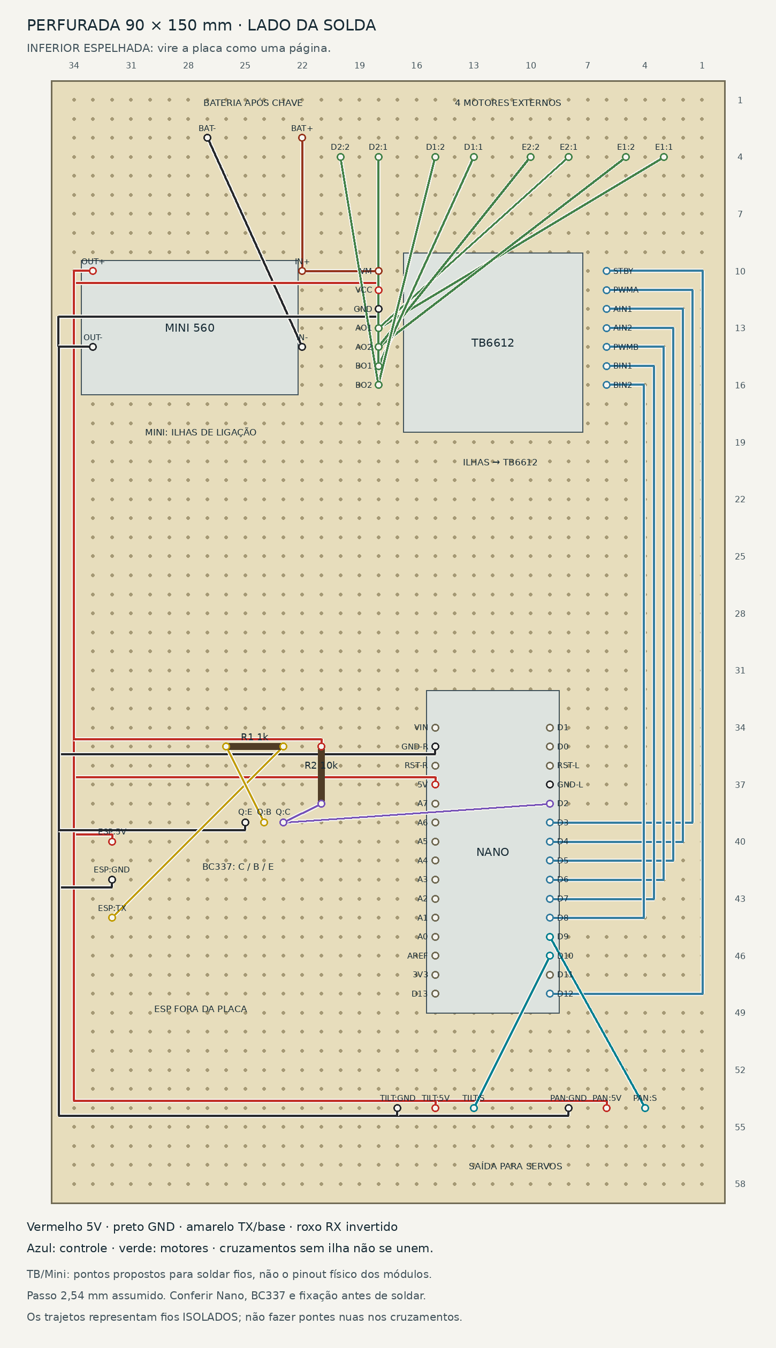
docs/hardware/kicad/rover_perfurada_90x150/montagem_inferior.png
