CaioHVectorA/rover/docs/hardware/kicad/rover_pcb_v2_chassi/rover_pcb_v2_chassi.kicad_pcb

## KiCad design docs/hardware/kicad/rover_pcb_v2_chassi/rover_pcb_v2_chassi.kicad_pcb (2026-11-13)

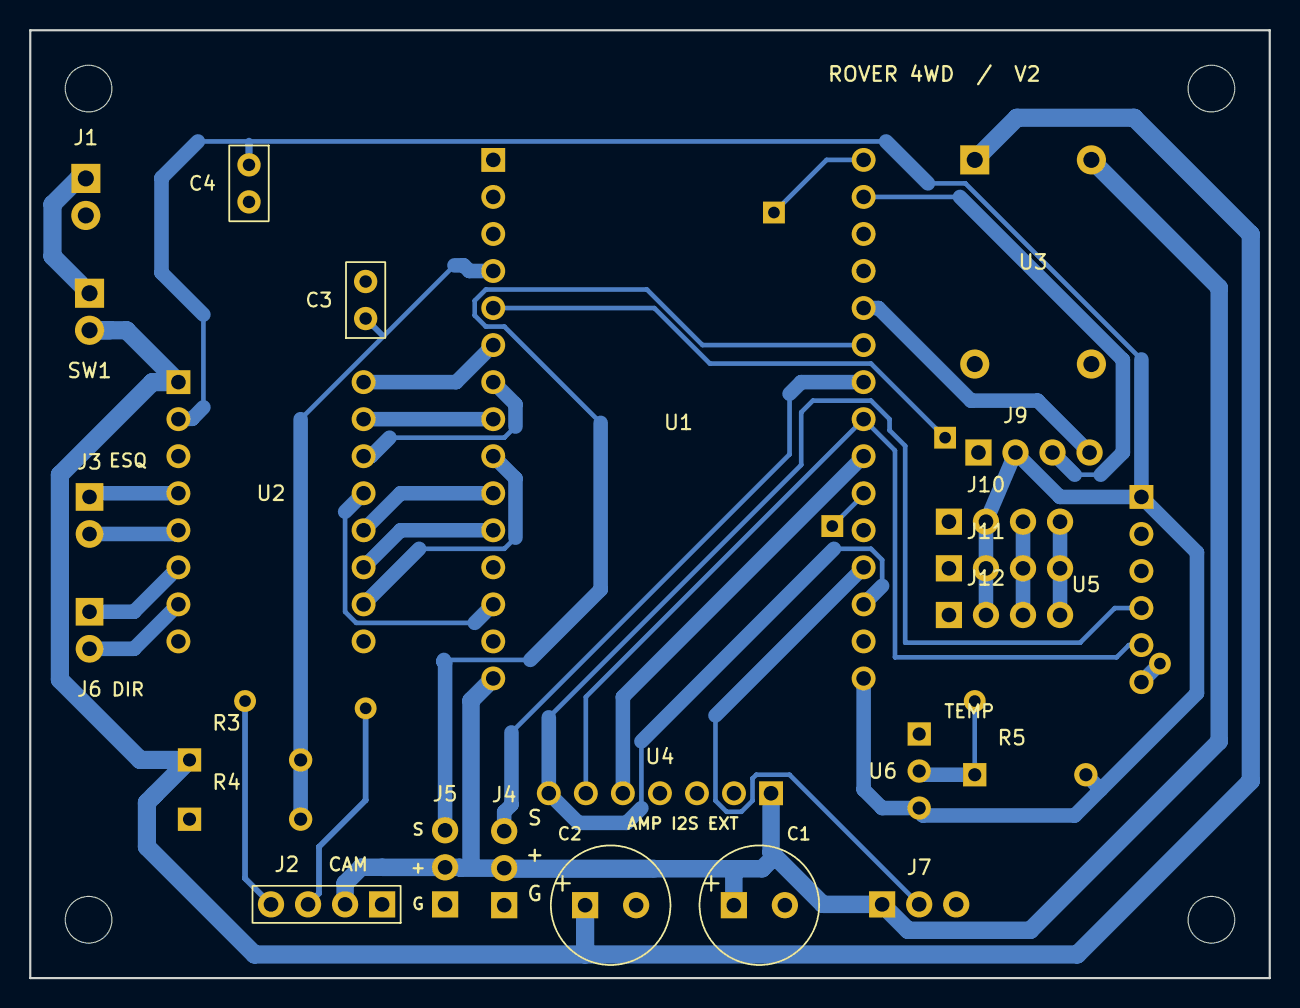
[picture p21: board rover_pcb_v2_chassi.kicad_pcb from above]

Board: 2 copper layers, 85.0 x 65.0 mm, 35 parts (0 on the bottom side), 29 nets.

Parts:
C1: 470uF 16V; C_EL_P35
C2: 470uF 25V; C_EL_P35
C3, C4: 100nF; C_CER_P25
H1, H2, H3, H4: M3
J1: Bateria 2S; J1
J2: Camera UART 5V; J2
J3: Motor esquerdo; J3
J4: Servo PAN; J4
J5: Servo TILT; J5
J6: Motor direito; J6
J7: WS2812B; J7
J9: OLED I2C; J9
J10: I2C AUX 1; J9
J11: I2C AUX 2; J9
J12: I2C AUX 3; J9
JP1, JP2, JP3, JP4, JP5, JP6: FIO JUMPER ISOLADO; J3
R3: 10k; R3
R4: 4.7k; R4
R5: 4.7k; R5
SW1: Chave externa; SW1
U1: ESP32 DevKit V1 (30p); U1
U2: TB6612FNG; U2
U3: Mini 560; U3
U4: MAX98357A; U4
U5: INMP441; U5
U6: DS18B20; U6

Connections:
/+3V3: C4.1, J9.2 (+3V3), J10.2, J11.2, J12.2, R5.2, U1.1 (3V3), U2.2 (VCC), U5.1 (VDD), U6.3 (3V3)
/+5V: C1.1, J2.2, J4.2 (+5V), J5.2 (+5V), J7.1 (+5V), U1.30 (VIN), U3.3 (5V), U4.1 (Vin)
/BAT_RAW: J1.1 (BAT+), SW1.1 (IN)
/CAM-RX: J2.4, JP6.1, U1.15 (D23)
/CAM-TX: J2.3, JP5.1, U1.6 (RX2)
/GND: C1.2, C2.2, C3.2, C4.2, J1.2 (GND), J2.1, J4.1 (GND), J5.1 (GND), J7.3 (GND), J9.1 (GND), J10.1, J11.1, J12.1, R4.1, U1.2 (GND2), U1.29 (GND1), U2.3 (GND), U2.8 (GND2), U2.16 (GND3), U3.2 (IN-), U3.4 (GND), U4.2 (GND), U5.2 (GND), U5.3 (L/R), U6.1 (GND)
/I2S-BCLK: U1.8 (D5), U4.6 (BCLK), U5.5 (SCK)
/I2S-DIN: JP1.1 (I2S-DIN), U1.20 (D35), U5.6 (SD)
/I2S-DOUT: U1.7 (GPIO17 / TX2), U4.5 (DIN)
/I2S-WS: U1.3 (D15), U4.7 (LRC), U5.4 (WS)
/LED-DIN: J7.2 (LED-DIN), U1.4 (D2)
/MOT-AIN1: U1.22 (D33), U2.11 (AIN1)
/MOT-AIN2: U1.23 (D25), U2.10 (AIN2)
/MOT-BIN1: U1.25 (D27), U2.13 (BIN1)
/MOT-BIN2: U1.26 (D14), U2.14 (BIN2)
/MOT-PWMA: U1.21 (D32), U2.9 (PWMA)
/MOT-PWMB: U1.24 (D26), U2.15 (PWMB)
/MOT-STBY: U1.28 (D13), U2.12 (STBY)
/MOT_DIR_BO1: J6.2 (BO1), U2.7 (BO1)
/MOT_DIR_BO2: J6.1 (BO2), U2.6 (BO2)
/MOT_ESQ_AO1: J3.1 (AO1), U2.4 (AO1)
/MOT_ESQ_AO2: J3.2 (AO2), U2.5 (AO2)
/OLED-SCL: J9.3 (OLED-SCL), J10.3, J11.3, J12.3, JP4.1 (OLED-SCL), U1.14 (D22)
/OLED-SDA: J9.4 (OLED-SDA), J10.4, J11.4, J12.4, JP3.1 (OLED-SDA), U1.11 (D21)
/SERVO-PAN: J4.3 (SINAL), U1.9 (D18)
/SERVO-TILT: J5.3 (SINAL), U1.10 (D19)
/TEMP-DATA: JP2.1 (TEMP-DATA), R5.1, U1.5 (D4), U6.2 (DQ)
/VBAT-SENSE: C3.1, R3.2, R4.2, U1.19 (D34)
/VCC_BAT: C2.1, R3.1, SW1.2 (OUT), U2.1 (VM), U3.1 (IN+)
