CaioHVectorA/rover/docs/hardware/kicad/rover_serial_bridge/rover_serial_bridge.kicad_pcb

## KiCad design docs/hardware/kicad/rover_serial_bridge/rover_serial_bridge.kicad_pcb (2026-10-24)

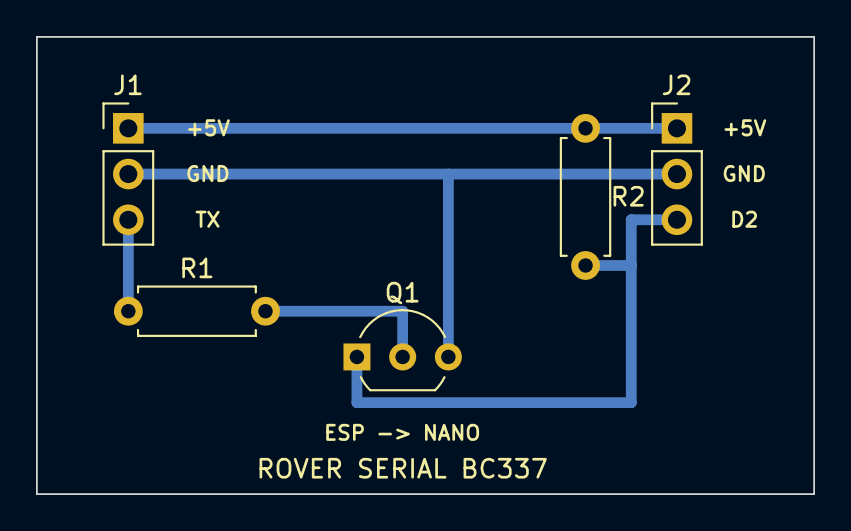
[picture p22: board rover_serial_bridge.kicad_pcb from above]

Board: 2 copper layers, 43.2 x 25.4 mm, 5 parts (0 on the bottom side), 5 nets.

Parts:
J1: Cabeca_ESP; PinHeader_1x03_P2.54mm_Vertical
J2: Nano; PinHeader_1x03_P2.54mm_Vertical
Q1: BC337; TO-92_Inline_Wide
R1: 1k; R_Axial_DIN0207_L6.3mm_D2.5mm_P7.62mm_Horizontal
R2: 10k; R_Axial_DIN0207_L6.3mm_D2.5mm_P7.62mm_Horizontal

Connections:
+5V: J1.1, J2.1, R2.1
BASE_Q1: Q1.2, R1.2
ESP_TX_3V3: J1.3, R1.1
GND: J1.2, J2.2, Q1.3
NANO_D2: J2.3, Q1.1, R2.2
