CaioHVectorA/rover/src/firmware/producao/esp32/main.cpp

// ====================================================================================
// ROVER TOTAL - ESP32: CÂMERA (EQUILIBRADA) + MOTORES 4WD + PAN/TILT
// ====================================================================================
#define POC_NOME   "rover_total"
#define POC_AP     "Rover-Total"
#define POC_CAM    1
#define POC_SERVO  1
#define POC_MOTOR  1
#include "esp_app.h"
