CaioHVectorA/rover/(commit log)

2026-09-25 feat: encerra compras, consolida linha ESP32 e cria projetos de eletrica e case/pan-tilt
2026-09-25 docs: centraliza memoria de conversa, eletrica e projeto 3D no README
2026-09-25 docs: ajusta README para refletir estritamente o estado real e acordos feitos
2026-09-25 docs: adiciona diretriz para incrementar o README a cada troca de mensagens
2026-09-25 feat: adiciona pasta inspiracoes com referencias de cases 3D e atualiza README
2026-09-25 docs: valida case fechado, rodas sumo, cabeca encapsulada e cinematica Pan na base / Tilt no topo
2026-09-25 docs: remove imagens de IA, adiciona fotos reais dos componentes e detalha dimensoes e diametro das rodas no README
2026-09-25 docs: atualiza especificacoes para motores JGA-050 e rodas de 32mm no README
2026-09-25 docs: confirma rodas StickyMAX 22mm e micromotores RoboCore com calculo de folga
2026-09-25 docs: define motores JGA-050 com rodas 22mm e estrategia de 3mm de folga
2026-09-26 docs: atualiza documentacao tecnica, planilha de pinagem e arquitetura eletrica do rover
2026-10-02 feat: implement low-latency cloud relay on Fly.io (gru) and ESP32-S3 WSS client
2026-10-06 feat: add PlatformIO configuration and C++ source files for ESP32 and Arduino Nano rover controllers
2026-10-10 Adiciona codigos de teste de bancada dos pinos Nano via Web e atualiza README
2026-10-14 Organiza rover, adiciona app e KiCad e revisa planejamento de compras
2026-10-14 feat: adiciona Display TFT 3.5 Touch e 10 botoes tacteis na planilha de compras
2026-10-14 feat: simplifica planilha em aba unica e adiciona kit 10 capas para push buttons
2026-10-24 feat: reorganiza codebase, implementa suite de 6 POCs, otimizacao termica OV5640 e rampa anti-brownout
2026-10-24 docs: atualiza style.md com aprendizados da sessao de POCs e raiz limpa
2026-10-26 feat: integra rover total (camera ov5640, pan/tilt e tracao 4wd) com cockpit web e ajuste de velocidade dos servos
2026-10-26 feat: adiciona modo joystick virtual, inversao de eixos e seletor de resolucao de video
2026-10-27 feat(bancada): adiciona suite de testes com controle de LED D13, motores 4WD e seletor de polaridade TX
2026-10-29 feat(mobile): adiciona head-tracking robusto com giroscopio, radar de teste e suporte a expo dev client
2026-10-29 fix(mobile): corrige rota do stream mjpeg na porta 82 e normaliza orientacao do servo tilt
2026-11-09 feat(hardware): projeto e esquematico KiCad da nova PCB do chassi (v2_2esps)
    - Adiciona projeto e esquematico no KiCad em docs/hardware/kicad/rover_pcb_v2_chassi/
    - Substitui Arduino Nano por ESP32 DevKit V1 30 pinos no chassi
    - Integra audio I2S (MAX98357A + INMP441), OLED SSD1306, temp DS18B20 e WS2812B
    - Atualiza aba v2_2esps em docs/hardware/tabela_pinagem_esp32_nano.xlsx
    - Atualiza docs/context.md e style.md com o racional da arquitetura
2026-11-09 fix(kicad): aninhar tag bold dentro de font no esquematico rover_pcb_v2_chassi
2026-11-09 feat(kicad): adiciona layout da PCB compacta 85x65mm (rover_pcb_v2_chassi.kicad_pcb) e print visual
    - Gera rover_pcb_v2_chassi.kicad_pcb com posicionamento de todos os modulos THT 2.54mm e trilhas F.Cu/B.Cu
    - Adiciona 4 furos de fixacao M3 nos cantos para o chassi 3D em ABS
    - Inclui preview_pcb_top.png renderizado em alta resolucao
    - Atualiza rover_pcb_v2_chassi.kicad_pro e docs/context.md
2026-11-09 feat(cv): gestos mao, modelos ultra/adaptativo e controle de ganho progressivo anti-oscilacao
2026-11-11 feat(hardware): atualiza pcb v2 chassi face simples, modelos 3d e documentacao de bancada
2026-11-11 refactor(hardware): atualiza layout pcb v2 chassi com solda direta, mini 560 reposicionado e documentacao
2026-11-11 feat(pocs): adiciona poc de streaming udp de alta performance e atualiza status de transicao v1->v2
2026-11-11 fix(hardware): resolve pendencias de drc no kicad (continuidade gnd, trilha 5v, bclk e temp-data)
2026-11-13 feat(hardware): atualiza pcb v2 chassi com expansao i2c, larguras 1mm e docs
2026-11-13 feat(hardware): atualiza pcb v2 com uart camera 4 vias em j2 e capacitores c1-c4
2026-11-13 docs(style): preserva aprendizados de 2026-11-09 apos sync com origin/main
